devent-no/timergate_2/README.md

# timergate
PCB, 3D models, Firmware and software for timergates.
