devent-no/timergate_2/Software/timergate-ap/README.md

| Supported Targets | ESP32 | ESP32-C2 | ESP32-C3 | ESP32-C6 | ESP32-S2 | ESP32-S3 |
| --- | ----- | --- | --- | --- | --- | --- |

# Timergate Access Point

## Overview

### Build and Flash

After the webpage design work has been finished, you should compile them by running following commands:

```bash
cd path_to_this_example/front/web-demo
npm install
npm run build
```

After a while, you will see a `dist` directory which contains all the website files (e.g. html, js, css, images).

Run `idf.py -p PORT flash monitor` to build and flash the project..

(To exit the serial monitor, type ``Ctrl-]``.)

See the [Getting Started Guide](https://docs.espressif.com/projects/esp-idf/en/latest/get-started/index.html) for full steps to configure and use ESP-IDF to build projects.

### Extra steps to do for deploying website by semihost

We need to run the latest version of OpenOCD which should support semihost feature when we test this deploy mode:

```bash
openocd-esp32/bin/openocd -s openocd-esp32/share/openocd/scripts -f board/esp32-wrover-kit-3.3v.cfg
```

## Example Output

### Render webpage in browser

In your browser, enter the URL where the website located (e.g. `http://timergate.local`). You can also enter the IP address that ESP32 obtained if your operating system currently don't have support for mDNS service.

Besides that, this example also enables the NetBIOS feature with the domain name `timergate`. If your OS supports NetBIOS and has enabled it (e.g. Windows has native support for NetBIOS), then the URL `http://timergate` should also work.
