devent-no/timergate_2/Software/timergate-gui/README.md

# timergate-gui

This is a Vue 3 app with the Timergate gui.
This needs to be built before being packaged and added to the timergate AP. 

## Project Setup

```sh
npm install
```

### Compile and Hot-Reload for Development

```sh
npm run dev
```

### Compile and Minify for Production

```sh
npm run build
```

### Lint with [ESLint](https://eslint.org/)

```sh
npm run lint
```
