devent-no/timergate_2/PCB/IR-sensor-A2/Notes.txt

Notes Devent IR-sensor A1 -> A2
===============================

- Add DC block on receiver to remove sunlight. 
- Remove
