devent-no/timergate_2/BoM/BoM.pdf

# BoM Devent IR-sensor

Vare | Antall | Pris | Pris totalt | MPN | Supplier | Inventar | Behov | Innkjøp | Pris innkjøp
Aluramme | 2 | $37.14 | $74.28 | EN AW-6060 T66 40X40X4MM U-PRO | Elfa | 1 | 6 | 5 | $185.70
PCB RX/TX | 1 | $5.56 | $5.56 | | JLCPCB | 5 | 4 | 0 | $0.00
PCBA RX/TX | 1 | $18.44 | $18.44 | | JLCPCB | 5 | 4 | 0 | $0.00
PCB sensor | 7 | $1.30 | $9.10 | | JLCPCB | 10 | 28 | 18 | $23.40
PCBA sensor | 7 | $7.70 | $53.90 | | JLCPCB | 10 | 28 | 18 | $138.60
Ledninger for sensor | 7 | $2.85 | $19.95 | A08SUR08SUR32W305A | Digi-key | 4 | 28 | 24 | $68.40
Ladekrets | 1 | $7.48 | $7.48 | 18W Two-way 18650 | Banggood | 3 | 4 | 1 | $7.48
Batteri | 1 | $5.59 | $5.59 | USE-18650-2200PCB | Digi-key | 2 | 4 | 2 | $11.18
Antenne | 1 | $7.58 | $7.58 | ANT-24G-S21-P5FL | Digi-key | 2 | 4 | 2 | $15.16
Acryl-cover | 2 | 5 | $10.00 | 2 mm akryl | Bitmart | 0 | 4 | 4 | $20.00
USB-C-kontakt | 1 | 10.85 | $10.85 | USB C Type Connector | Aliexpress | 3 | 4 | 1 | $10.85
USB-C-ledning | 1 | 4.06 | $4.06 | CA-USB-AM-CM-3FT | Digi-key | 0 | 4 | 4 | $16.24
Refleks | 1 | 3.29 | $3.29 | 0.125-5-3431 | Digi-key | 4 | 0 | 0 | $0.00
Sum | | | $222.73 | | | | | | $497.01

3D-printede deler

Sensorskjerm | 7
Lokk | 1
Bunn | 1
Holder for lader | 1
