devent-no/timergate_2/BoM/BoM.ods

Vare | Antall | Pris | Pris totalt | MPN | Supplier | Inventar | Behov | Innkjøp | Pris innkjøp | OK | Link | Link2
Aluramme | 2 | $37.14 | $74.28 | EN AW-6060 T66 40X40X4MM U-PRO | Elfa | 4 | 8 | 4 | $148.56 | OK
PCB RX/TX | 1 | $5.56 | $5.56 |  | JLCPCB | 5 | 4 | 0 | $0.00 | OK
PCBA RX/TX | 1 | $18.44 | $18.44 |  | JLCPCB | 5 | 4 | 0 | $0.00 | OK
PCB sensor | 7 | $1.30 | $9.10 |  | JLCPCB | 10 | 28 | 18 | $23.40
PCBA sensor | 7 | $7.70 | $53.90 |  | JLCPCB | 10 | 28 | 18 | $138.60
IR-mottager | 7 | $0.56 | $3.92 | 1540051EC3590 | Digi-key | 10 | 28 | 18 | $10.08 | OK
IR-sender | 7 | $1.50 | $10.50 | VSLY5940 | Digi-key | 10 | 28 | 18 | $27.00 | OK
Ledninger for sensor | 7 | $2.85 | $19.95 | A08SUR08SUR32W305A | Digi-key | 4 | 28 | 24 | $68.40 | OK
Ladekrets | 1 | $7.48 | $7.48 | 18W Two-way 18650 | Banggood/pfdeal | 3 | 4 | 1 | $7.48 | OK | https://www.pfdeal.com/products/18w-two-way-18650-battery-fast-charge-shield-board-for-lipo-battery | https://www.banggood.com/18W-Two-way-18650-Battery-Fast-Charge-Shield-Board-for-Lipo-Battery-p-1931453.html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
Batteri | 1 | $5.59 | $5.59 | USE-18650-2200PCB | Kjell.com | 2 | 4 | 2 | $11.18 |  | https://www.kjell.com/no/produkter/kontor/batterier/litiumbatterier/kjell-company-18650-li-ion-batteri-36-v-2600-mah-4-pk.-p32072
Antenne | 1 | $7.58 | $7.58 | ANT-24G-S21-P5FL | Digi-key | 4 | 4 | 0 | $0.00 | OK
Acryl-cover | 2 | 5 | $10.00 | 2 mm akryl | Bitmart | 0 | 4 | 4 | $20.00
Acryplate bunn | 2 |  |  | 4 mm acryl | Bitmart | 0 | 8 | 8
USB-C-kontakt | 1 | 10.85 | $10.85 | USB C Type Connector | Aliexpress | 4 | 4 | 0 | $0.00 | OK | https://www.aliexpress.com/item/1005002215361710.html
USB-C-ledning | 1 | 4.06 | $4.06 | CA-USB-AM-CM-3FT | Digi-key | 0 | 4 | 4 | $16.24 | OK
Refleks | 1 | 3.29 | $3.29 | 0.125-5-3431 | Digi-key | 4 | 0 | 0 | $0.00 | OK
M3 inserts-sensor | 34 | 0.11928 | $4.06 | M30X226C | Digi-key | 0
M3 inserts reflektor | 20 | 0.11928 | $2.39 | M30X226C | Digi-key | 0
M3x8 senkehode | 16
Sum |  |  | $237.15 |  |  |  |  |  | $470.94
3D-printede deler
Sensorskjerm | 7
Lokk | 1
Bunn | 1
Holder for lader | 1
Lokk-reflektor | 1
Bunn reflektor | 1
