devent-no/timergate_2/Models/Alu-Pole.FCStd

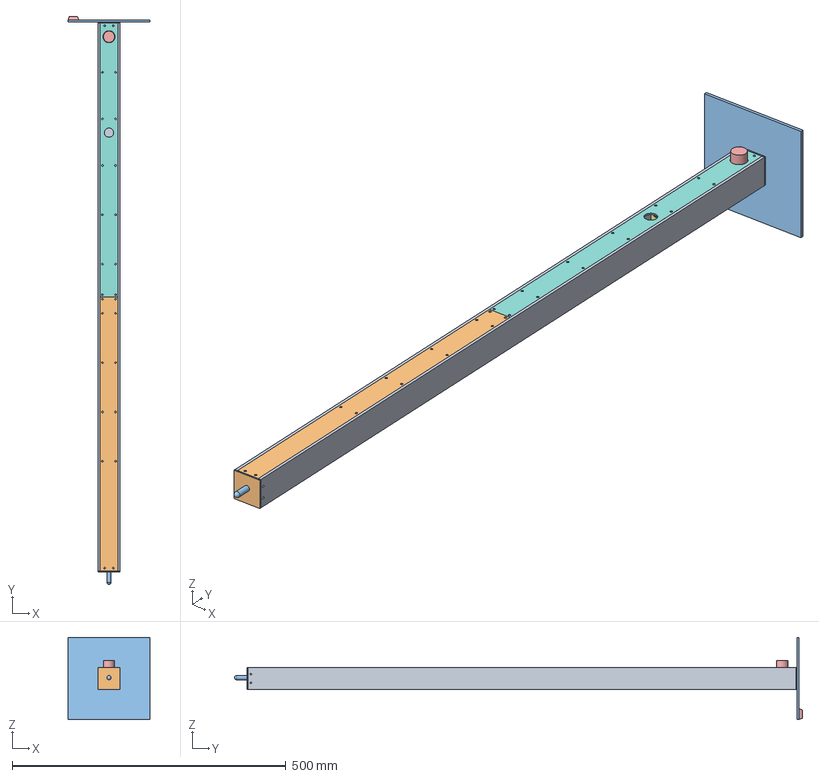
[picture p1: CAD file, 2025-02-21]
Models/Alu-Pole.FCStd
150.0 x 1037.0 x 150.0 mm
Aluminium-Profile
ABS-Top
Antenna
Charger
USB-C
ABS-Bottom
Charger-holder-2
Acrylic-front-bottom
Charger-holder-003
Acrylic-front-top
Acrylic-base
ABS-Joint
Rubber-Feet
Spacer
Old-Charger-holder
R_0402_1005Metric016
C_0402_1005Metric010
LED_D5.0mm
C_0402_1005Metric012
R_0402_1005Metric018
R_0402_1005Metric020
SOIC_14_39x87mm_P127mm
SOT-23-3
SOT_23
R_0402_1005Metric022
R_0402_1005Metric024
C_0402_1005Metric014
R_0402_1005Metric026
R_0402_1005Metric028
SOT_024
C_0402_1005Metric016
R_0402_1005Metric030
LED_D5.0mm002
R_0402_1005Metric032
R_0402_1005Metric034
R_0402_1005Metric036
PinSocket_2x10_P127mm_Horizontal001
C_0402_1005Metric018
R_0402_1005Metric038
PinHeader_2x10_P127mm_Horizontal
C_0402_1005Metric020
C_0402_1005Metric022
R_0402_1005Metric040
C_0402_1005Metric024
C_0402_1005Metric026
C_0402_1005Metric028
C_0402_1005Metric030
R_0402_1005Metric042
R_0402_1005Metric044
C_0402_1005Metric032
C_0402_1005Metric034
C_0402_1005Metric036
C_0402_1005Metric038
R_0402_1005Metric046
C_0402_1005Metric040
C_0402_1005Metric042
SOT_23_5
C_0402_1005Metric044
IR-sensor_PCB
USB-plug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
