devent-no/timergate_2/PCB/IR-sensor-A2/IR-sensor-A2.step

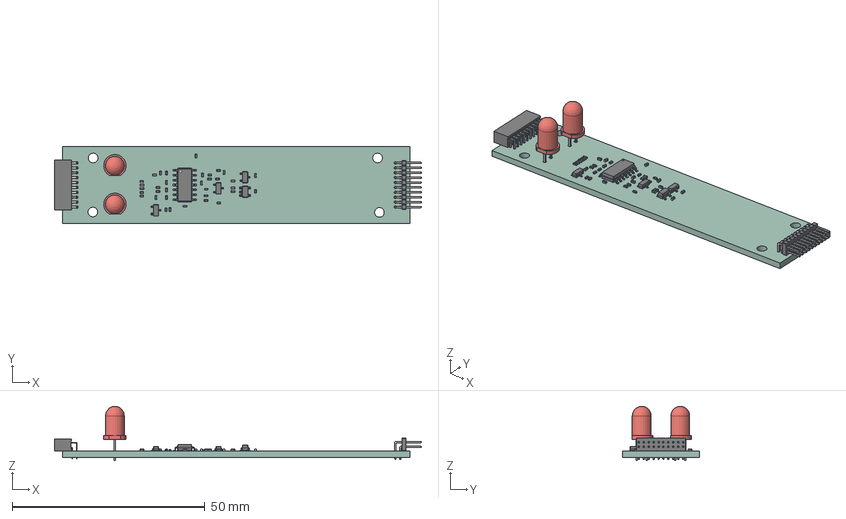
[picture p2: CAD file, 2025-01-06]
PCB/IR-sensor-A2/IR-sensor-A2.step
95.1 x 20.0 x 14.1 mm
R_0402_1005Metric x 16
C_0402_1005Metric x 18
LED_D5.0mm x 2
SOIC_14_39x87mm_P127mm
SOT-23-3
SOT_23 x 2
PinSocket_2x10_P127mm_Horizontal
PinHeader_2x10_P127mm_Horizontal
SOT_23_5
IR-sensor_PCB
