devent-no/timergate_2/PCB/Receiver-A0/Receiver.step

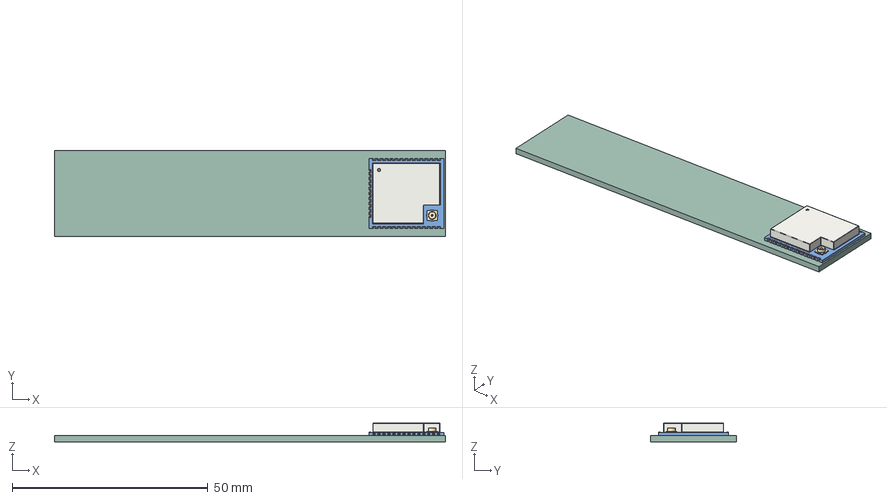
[picture p3: CAD file, 2024-08-15]
PCB/Receiver-A0/Receiver.step
100.0 x 22.0 x 4.85 mm
Receiver PCB
