devent-no/timergate_2/PCB/Receiver-A2/Receiver-A2.step

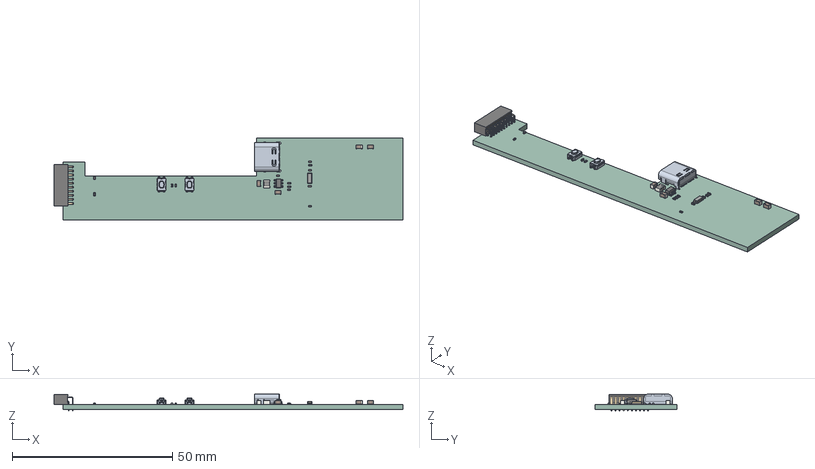
[picture p4: CAD file, 2025-01-06]
PCB/Receiver-A2/Receiver-A2.step
108.9 x 25.5 x 5.20 mm
C_0402_1005Metric x 5
C_0805_2012Metric x 4
L_1008_2520Metric
R_0402_1005Metric x 8
SOT_23_6
PinSocket_2x10_P127mm_Horizontal
Crystal_SMD_3215-2Pin_3.2x1.5mm
Receiver_PCB
