devent-no/timergate_2/Models/Alu-Calibration.FCStd

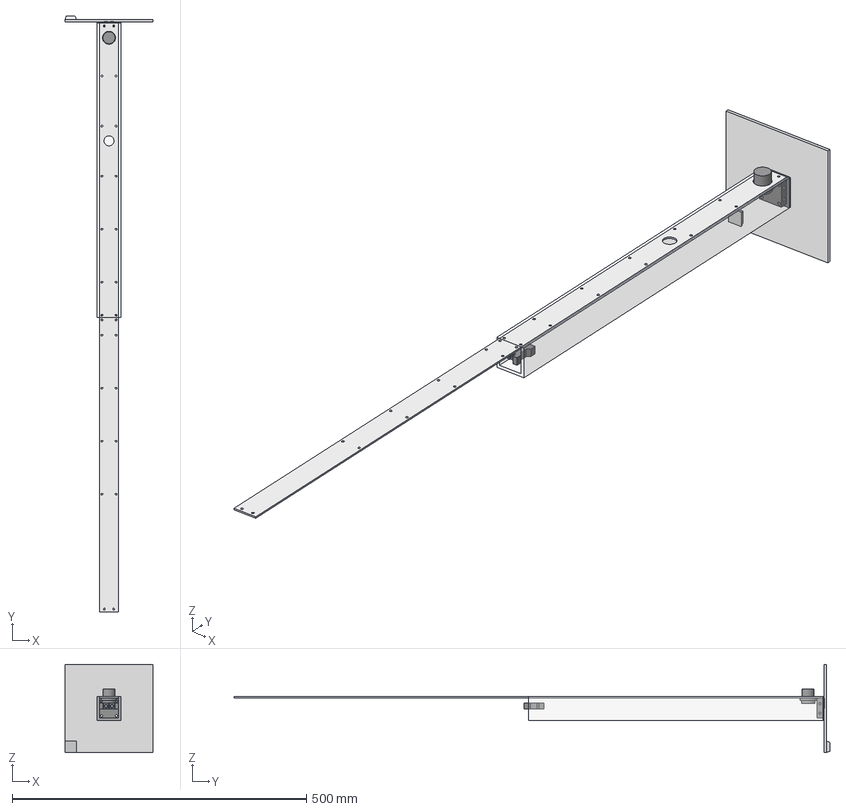
[picture p5: CAD file, 2025-01-06]
Models/Alu-Calibration.FCStd
150.0 x 1012.0 x 150.0 mm
Aluminium-Profile
USB-C
ABS-Bottom
Acrylic-front-bottom
Acrylic-front-top
Acrylic-base
Rubber-Feet
Sensor-holder-sun-3
