devent-no/timergate_2/PCB/IR-sensor-A2/IR-sensor.step

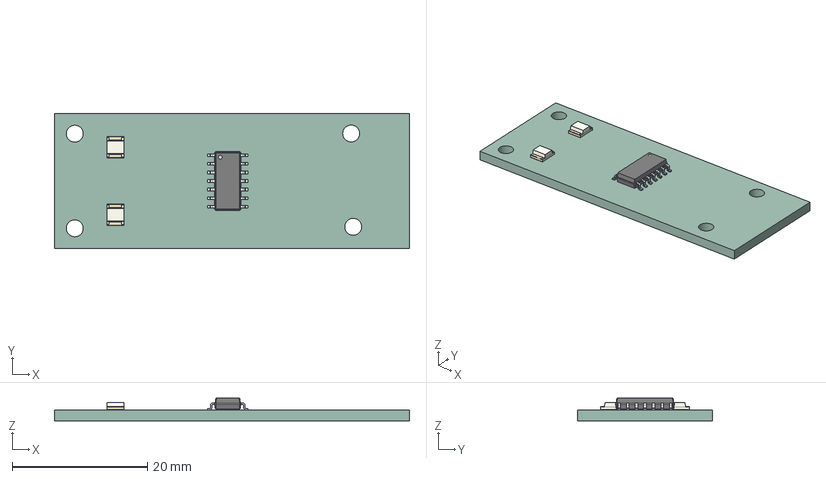
[picture p6: CAD file, 2024-08-15]
PCB/IR-sensor-A2/IR-sensor.step
52.5 x 20.0 x 3.40 mm
IR-sensor PCB
