devent-no/timergate_2/Models/Alu-Reflector.FCStd

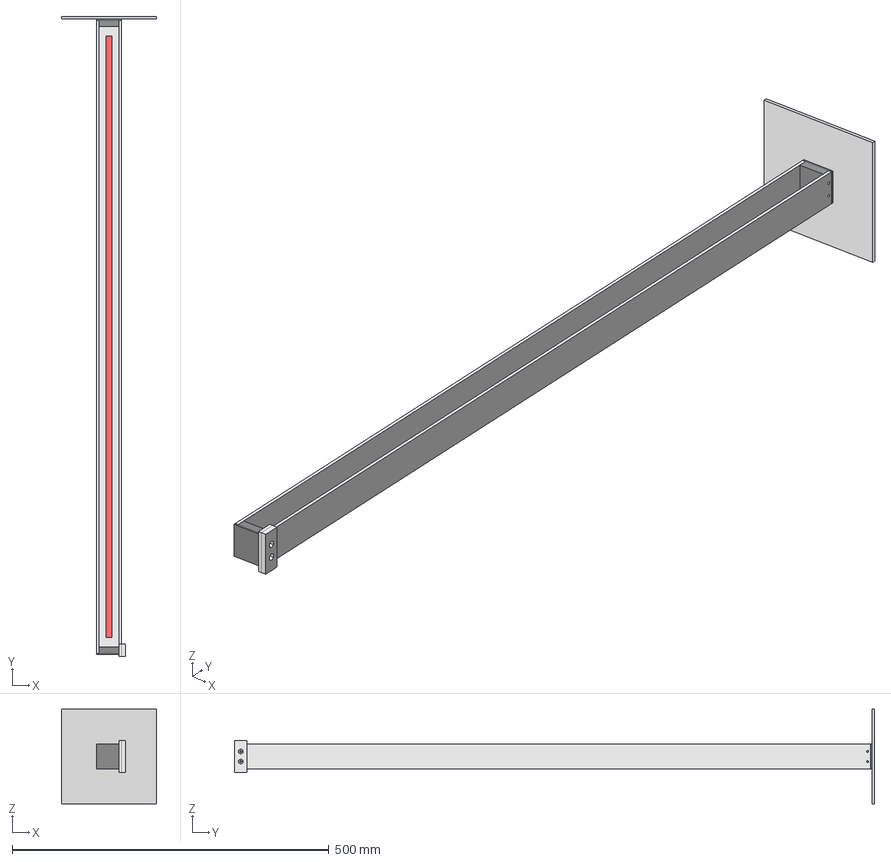
[picture p7: CAD file, 2024-08-20]
Models/Alu-Reflector.FCStd
150.0 x 1011.0 x 150.0 mm
Aluminium
Bottom
Top
Acrylic-bottom
Reflective-tape
Mal
