devent-no/timergate_2/Models/Alu-Base.FCStd

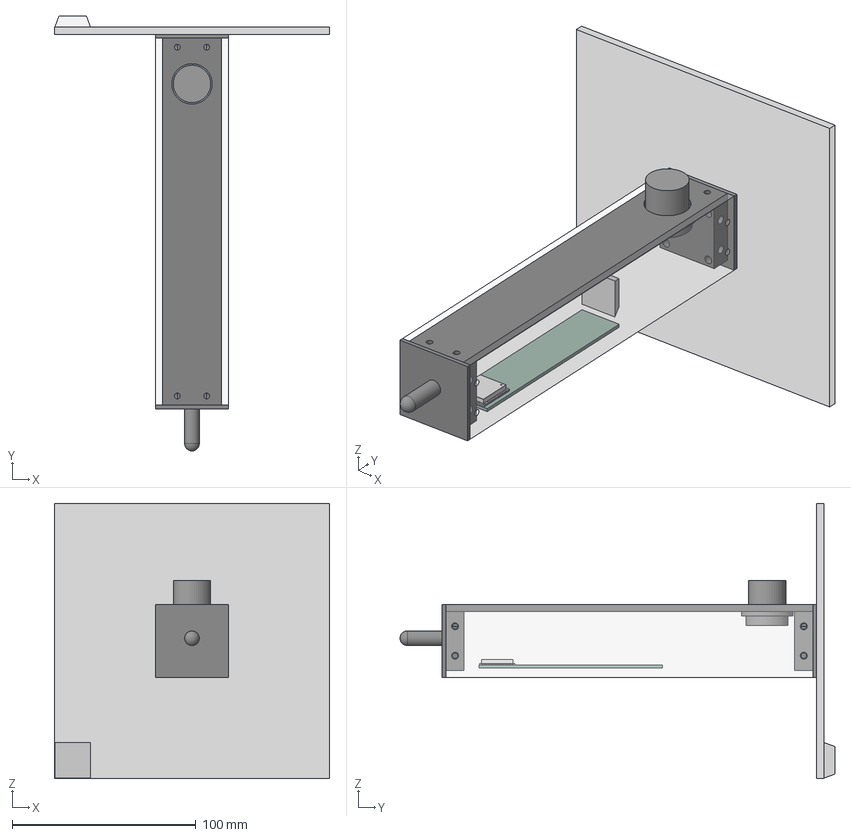
[picture p8: CAD file, 2024-08-15]
Models/Alu-Base.FCStd
150.0 x 237.0 x 150.0 mm
Aluminium
Receiver PCB
Top
Antenna
USB-C
Bottom
Acrylic-front
Acrylic-base
Feet
