devent-no/timergate_2/PCB/IR-sensor-A2/IR-sensor.kicad_pcb

## KiCad design PCB/IR-sensor-A2/IR-sensor.kicad_pcb (2025-02-20)

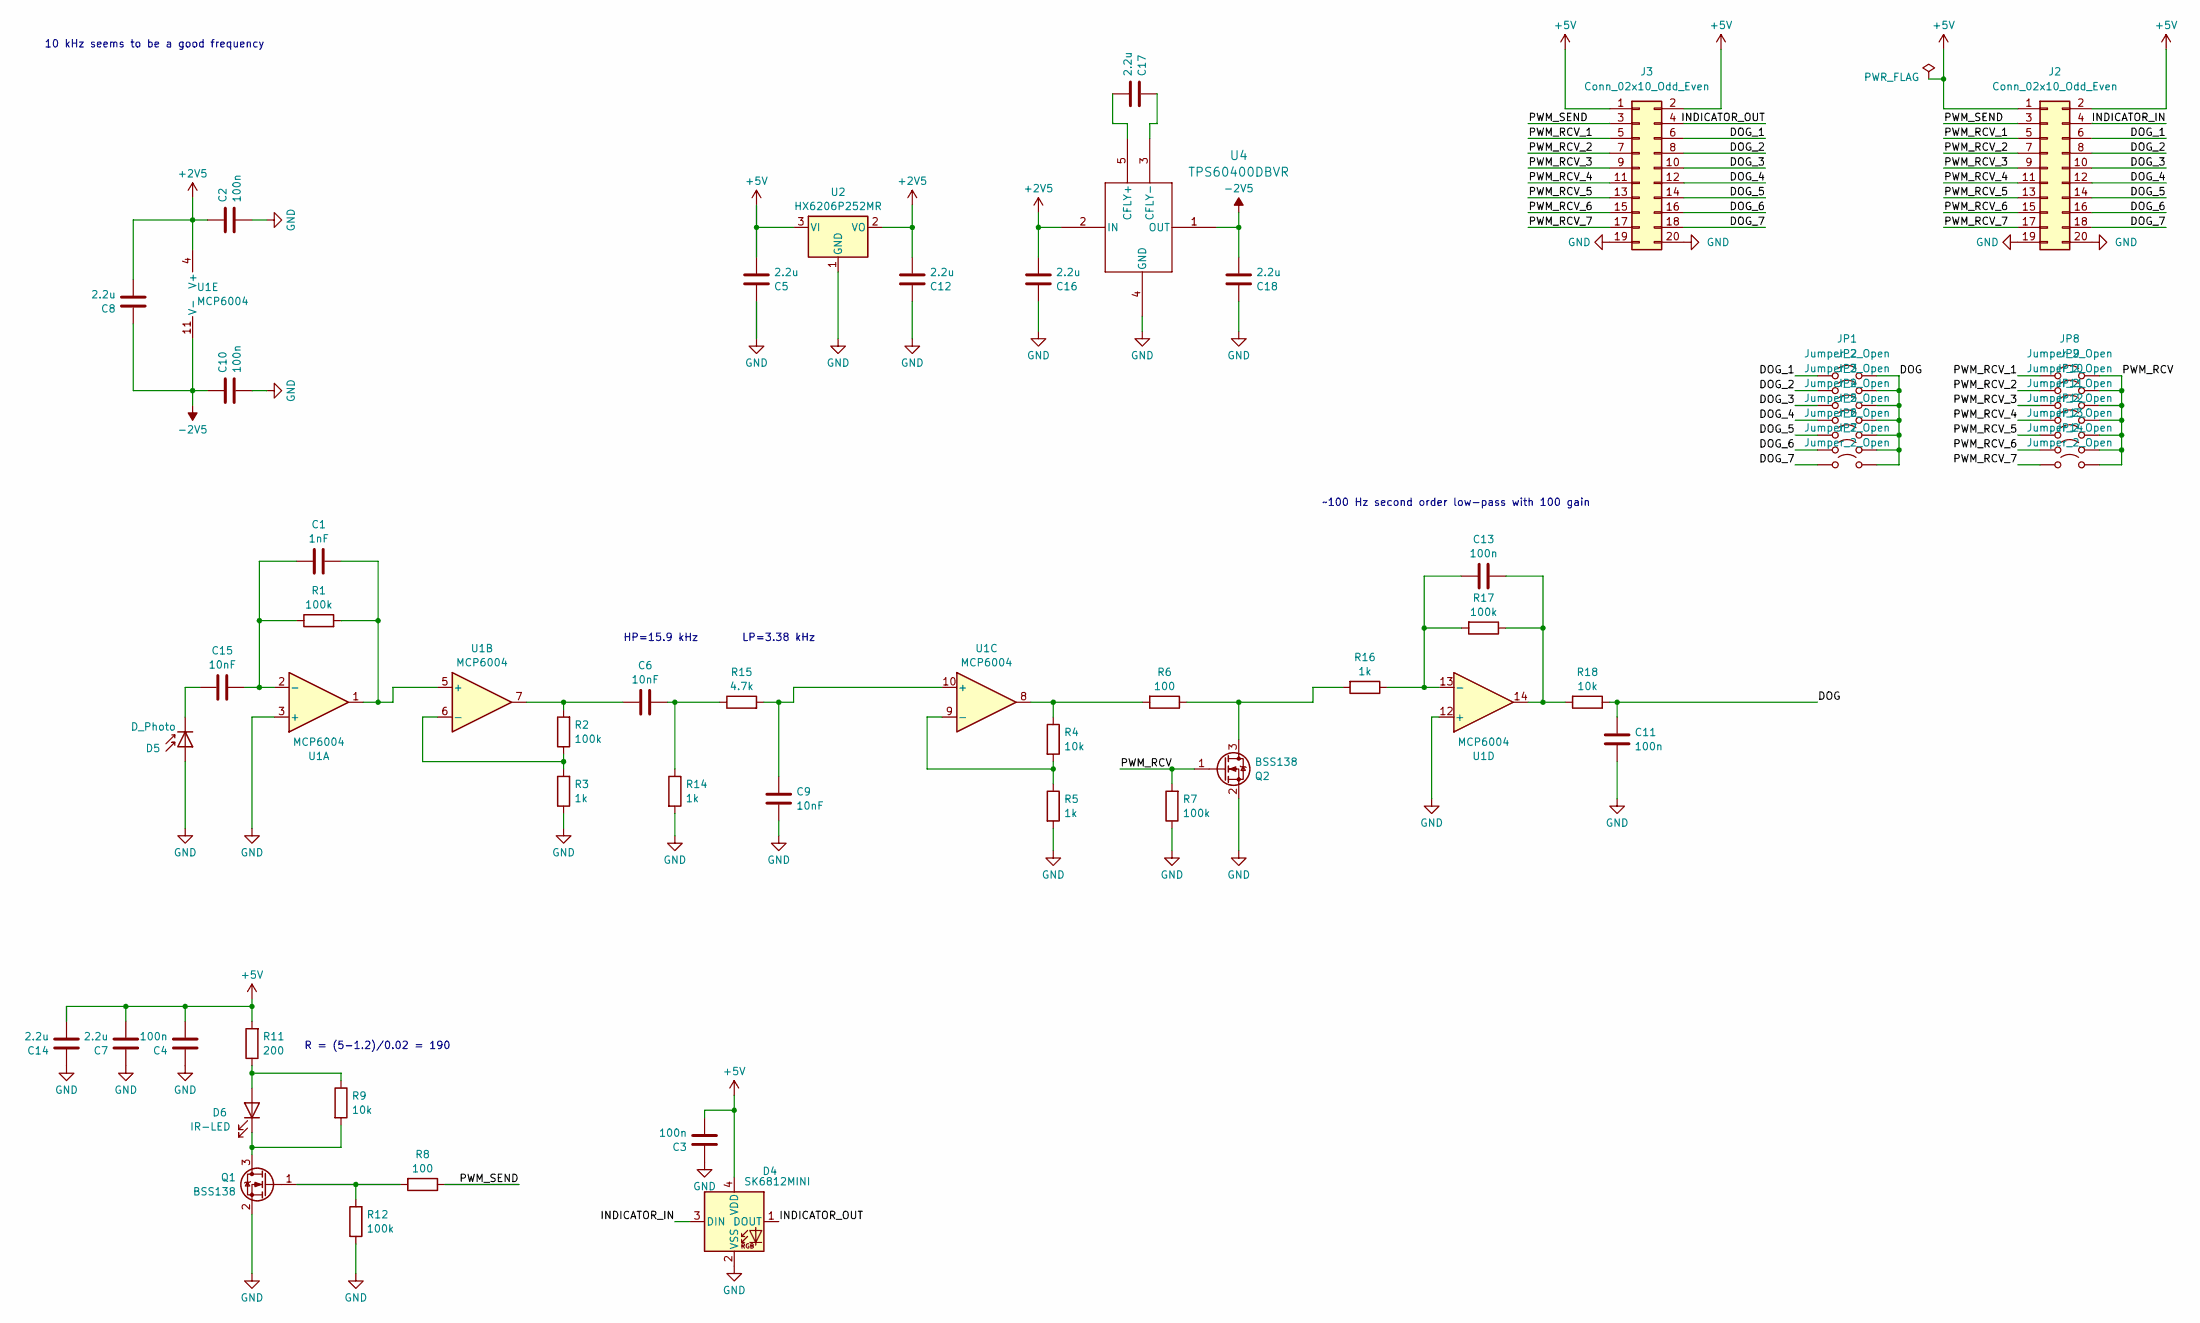
[picture p9: schematic IR-sensor.kicad_sch]

Parts:
C1: 1nF; C_0402_1005Metric; MPN CC0402KRX7R9BB102
C2, C3, C4, C10, C11, C13: 100n; C_0402_1005Metric; MPN CC0402KRX5R9BB104
C5, C7, C8, C12, C14, C16, C17, C18: 2.2u; C_0402_1005Metric; MPN CL05A225MQ5NSNC
C6, C9, C15: 10nF; C_0402_1005Metric; MPN CC0402KRX7R7BB103
D4: SK6812MINI; LED_SK6812MINI_PLCC4_3.5x3.5mm_P1.75mm; MPN SK6812mini
D5: D_Photo; LED_D5.0mm; MPN 1540051EC3590
D6: IR-LED; LED_D5.0mm; MPN VSLY5940
J2: Conn_02x10_Odd_Even; PinHeader_2x10_P1.27mm_Horizontal; MPN IPCP127M20PB28R
J3: Conn_02x10_Odd_Even; PinSocket_2x10_P1.27mm_Horizontal; MPN IPCP127F20PB28R
JP1, JP2, JP3, JP4, JP5, JP6, JP7, JP8, JP9, JP10, JP11, JP12, JP13, JP14: Jumper_2_Open; SolderJumper-2_P1.3mm_Open_Pad1.0x1.5mm
Q1, Q2: BSS138; SOT-23; MPN 4530-BSS138CT-ND
R1, R2, R7, R12, R17: 100k; R_0402_1005Metric; MPN RC0402FR-07100KL
R3, R5, R14, R16: 1k; R_0402_1005Metric; MPN 0402WGF1001TCE
R4, R9, R18: 10k; R_0402_1005Metric; MPN RC0402FR-0710KL
R6, R8: 100; R_0402_1005Metric; MPN RC0402FR-07100RL
R11: 200; R_0402_1005Metric; MPN 0402WGF2000TCE
R15: 4.7k; R_0402_1005Metric; MPN RC0402FR-074K7L
U1: MCP6004; SOIC-14_3.9x8.7mm_P1.27mm; MPN MCP6004T-I/SL
U2: HX6206P252MR; SOT-23-3; MPN HX6206P252MR
U4: TPS60400DBVR; SOT-23-5; MPN TPS60400DBVR

Connections:
+2V5: C2.2, C8.1, C12.2, C16.2, U1.4 (V+), U2.2 (VO), U4.2 (IN)
+5V: C3.1, C4.1, C5.2, C7.1, C14.1, D4.4 (VDD), J2.1, J2.2, J3.1, J3.2, R11.2, U2.3 (VI)
-2V5: C8.2, C10.2, C18.2, U1.11 (V-), U4.1 (OUT)
/DOG: C11.1, JP1.2 (B), JP2.2 (B), JP3.2 (B), JP4.2 (B), JP5.2 (B), JP6.2 (B), JP7.2 (B), R18.1
/DOG_1: J2.6, J3.6, JP1.1 (A)
/DOG_2: J2.8, J3.8, JP2.1 (A)
/DOG_3: J2.10, J3.10, JP3.1 (A)
/DOG_4: J2.12, J3.12, JP4.1 (A)
/DOG_5: J2.14, J3.14, JP5.1 (A)
/DOG_6: J2.16, J3.16, JP6.1 (A)
/DOG_7: J2.18, J3.18, JP7.1 (A)
/INDICATOR_IN: D4.3 (DIN), J2.4
/INDICATOR_OUT: D4.1 (DOUT), J3.4
/PWM_RCV: JP8.2 (B), JP9.2 (B), JP10.2 (B), JP11.2 (B), JP12.2 (B), JP13.2 (B), JP14.2 (B), Q2.1 (G), R7.2
/PWM_RCV_1: J2.5, J3.5, JP8.1 (A)
/PWM_RCV_2: J2.7, J3.7, JP9.1 (A)
/PWM_RCV_3: J2.9, J3.9, JP10.1 (A)
/PWM_RCV_4: J2.11, J3.11, JP11.1 (A)
/PWM_RCV_5: J2.13, J3.13, JP12.1 (A)
/PWM_RCV_6: J2.15, J3.15, JP13.1 (A)
/PWM_RCV_7: J2.17, J3.17, JP14.1 (A)
/PWM_SEND: J2.3, J3.3, R8.1
GND: C2.1, C3.2, C4.2, C5.1, C7.2, C9.2, C10.1, C11.2, C12.1, C14.2, C16.1, C18.1, D4.2 (VSS), D5.2 (A), J2.19, J2.20, J3.19, J3.20, Q1.2 (S), Q2.2 (S), R3.1, R5.2, R7.1, R12.1, R14.2, U1.3 (+), U1.12 (+), U2.1 (GND), U4.4 (GND)
unnamed: C6.1, R14.1, R15.1
unnamed: C6.2, R2.2, U1.7
unnamed: C13.1, R17.1, R18.2, U1.14
unnamed: C15.2, D5.1 (K)
unnamed: D6.2 (A), R9.1, R11.1
unnamed: D6.1 (K), Q1.3 (D), R9.2
unnamed: Q1.1 (G), R8.2, R12.2
unnamed: Q2.3 (D), R6.1, R16.2
unnamed: R4.1, R6.2, U1.8
unnamed: C1.1, C15.1, R1.1, U1.2 (-)
unnamed: C1.2, R1.2, U1.1, U1.5 (+)
unnamed: R2.1, R3.2, U1.6 (-)
unnamed: C9.1, R15.2, U1.10 (+)
unnamed: R4.2, R5.1, U1.9 (-)
unnamed: C13.2, R16.1, R17.2, U1.13 (-)
unnamed: C17.2, U4.5 (CFLY+)
unnamed: C17.1, U4.3 (CFLY-)

Notes on the sheet:
R = (5-1.2)/0.02 = 190
LP=3.38 kHz
10 kHz seems to be a good frequency
HP=15.9 kHz
~100 Hz second order low-pass with 100 gain

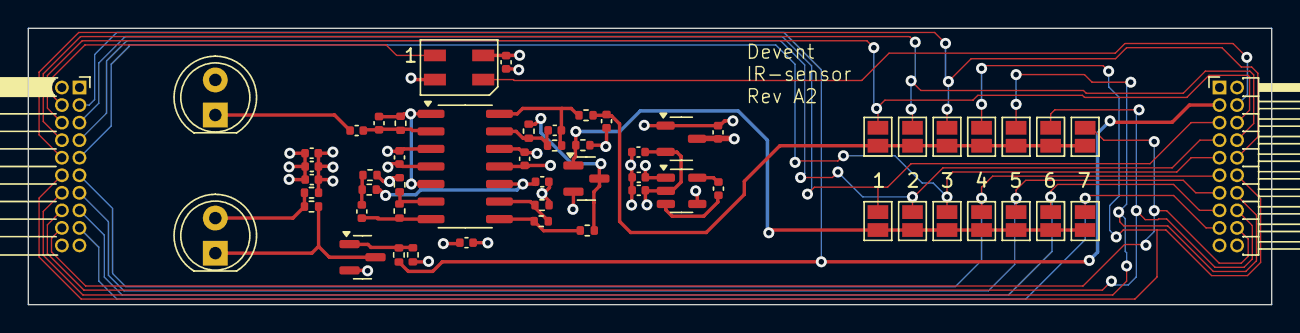
[picture p10: board PCB/IR-sensor-A2/IR-sensor.kicad_pcb from above]

Board: 4 copper layers, 90.0 x 20.0 mm, 58 parts (0 on the bottom side), 40 nets.
