devent-no/timergate_2/PCB/Receiver-A2/Receiver.kicad_pcb

## KiCad design PCB/Receiver-A2/Receiver.kicad_pcb (2025-02-20)

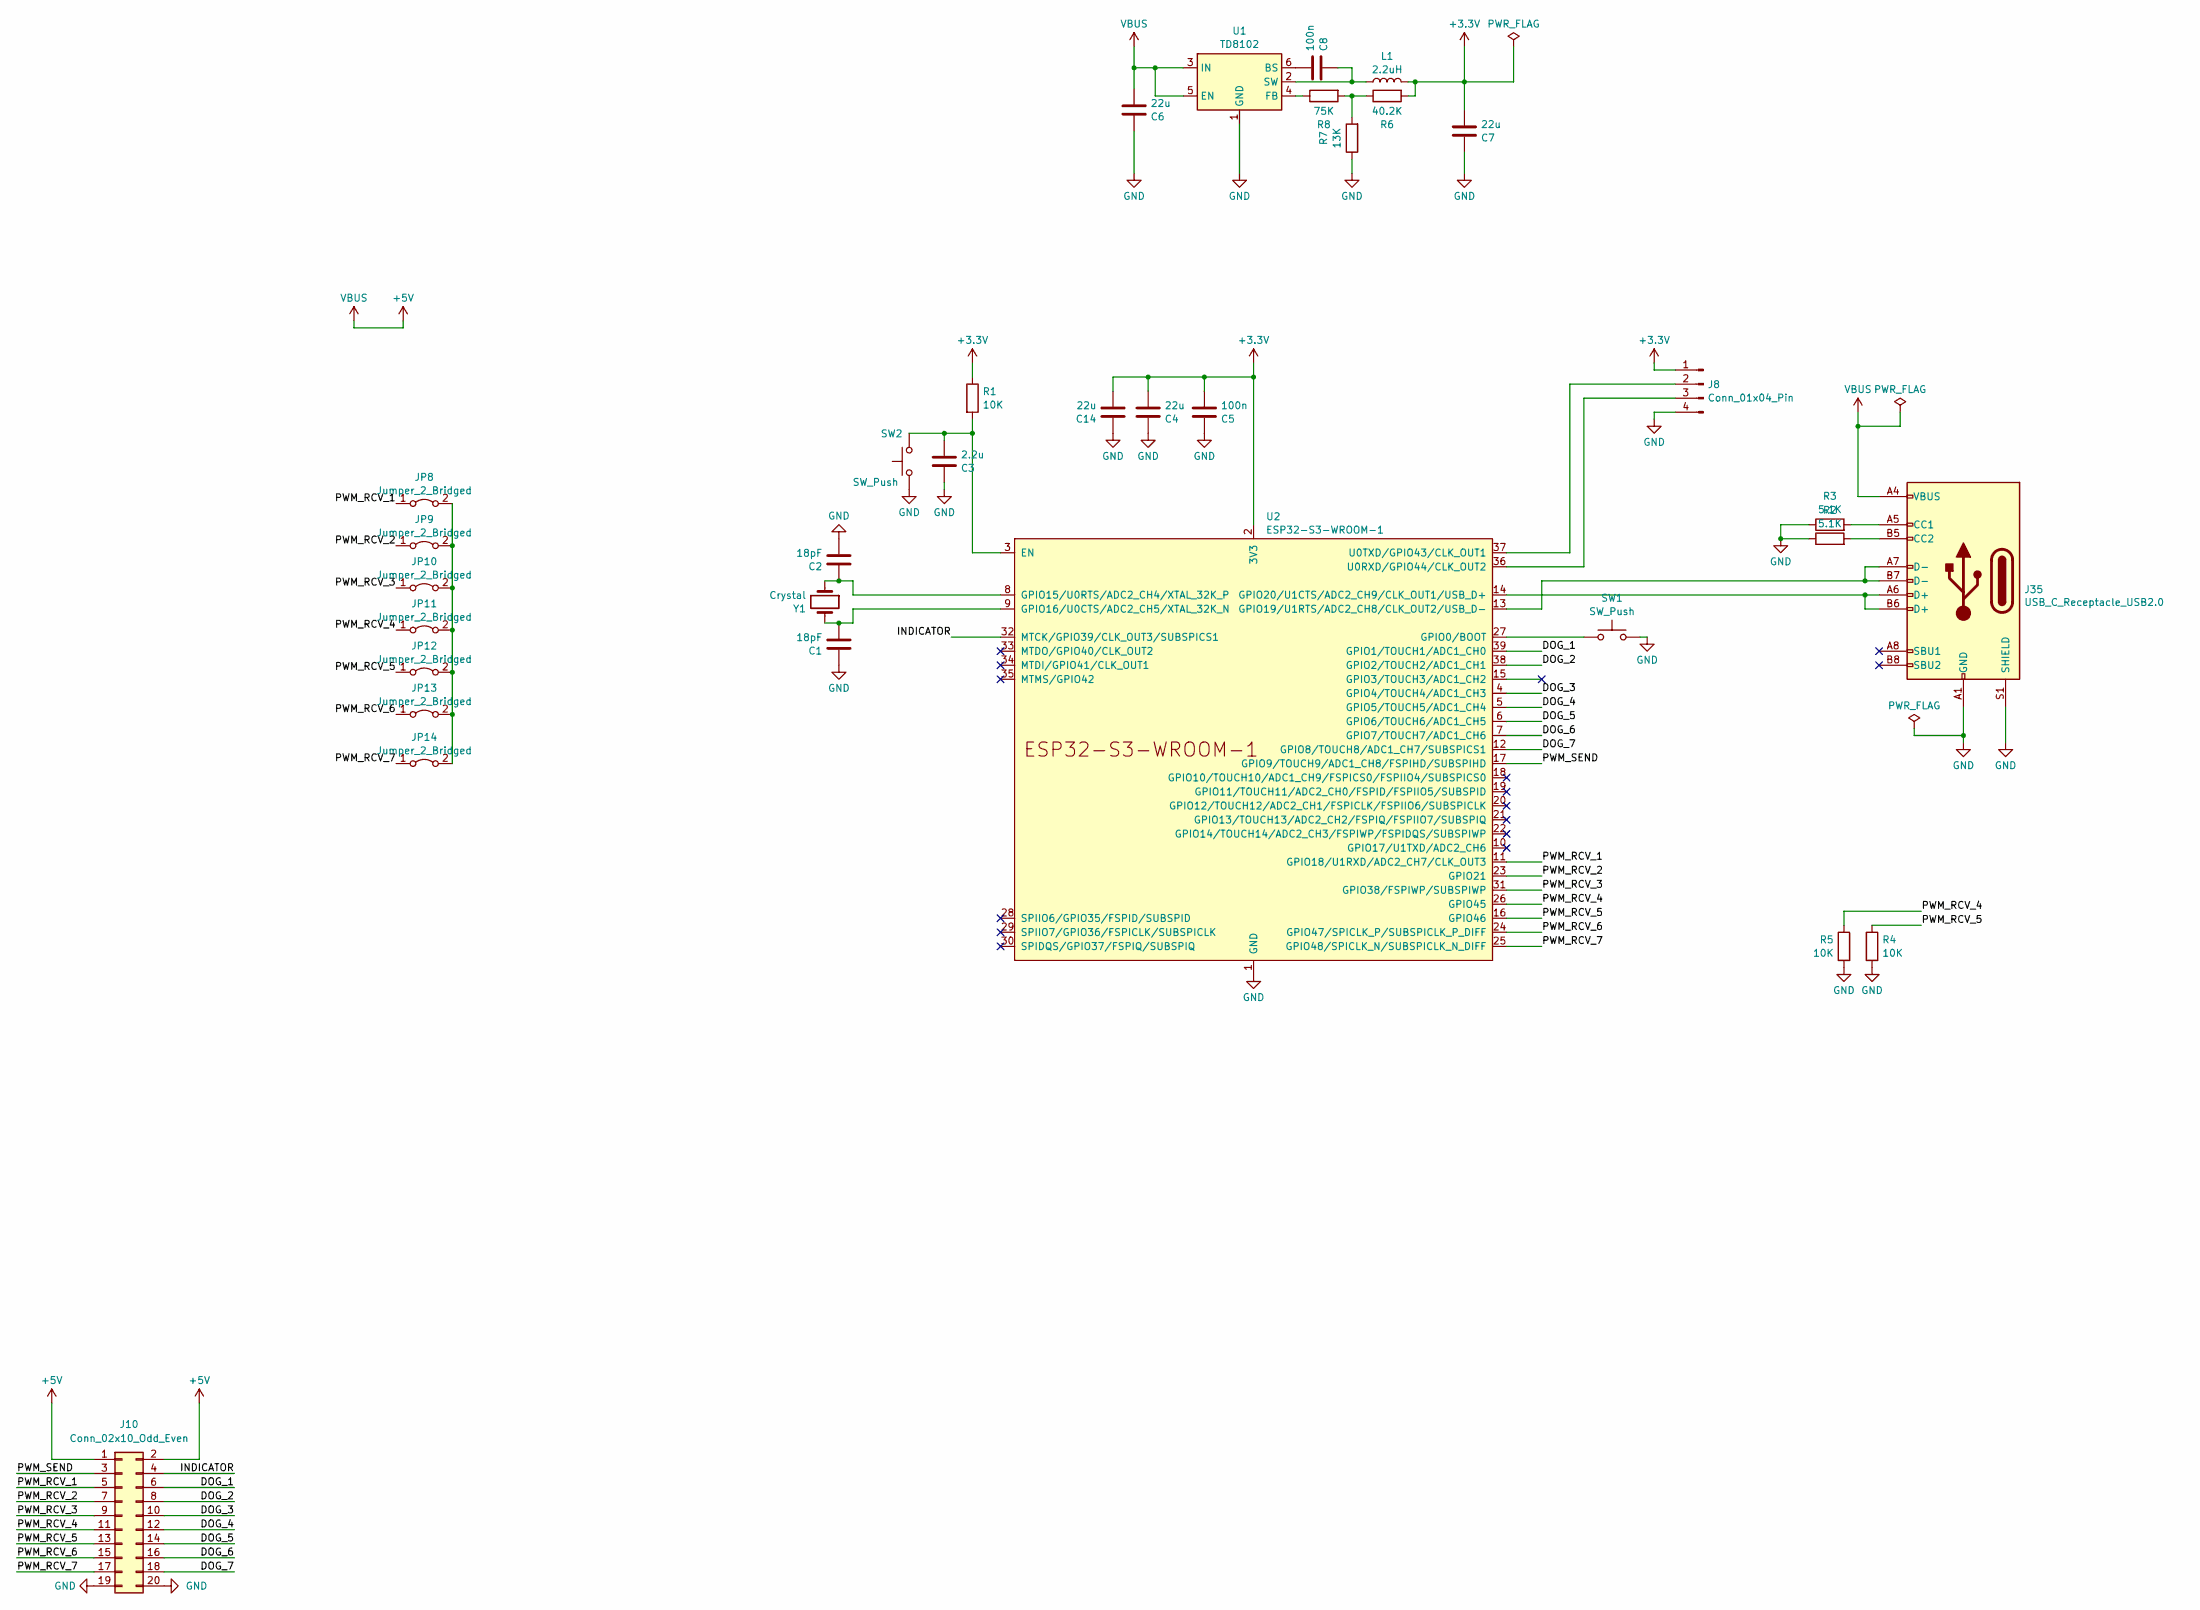
[picture p11: schematic Receiver.kicad_sch, Timergate-Receiver]

Parts:
C1, C2: 18pF; C_0402_1005Metric; MPN CC0402JRNPO9BN180
C3: 2.2u; C_0402_1005Metric; MPN CL05A225MQ5NSNC
C4, C6, C7, C14: 22u; C_0805_2012Metric; MPN CL21A226MPQNNNG
C5, C8: 100n; C_0402_1005Metric; MPN CC0402KRX5R9BB104
J8: Conn_01x04_Pin; PinHeader_1x04_P2.54mm_Vertical_SMD_Pin1Left
J10: Conn_02x10_Odd_Even; PinSocket_2x10_P1.27mm_Horizontal; MPN IPCP127F20PB28R
J35: USB_C_Receptacle_USB2.0; USB-C; MPN U262-161N-4BVC11
JP8, JP9, JP10, JP11, JP12, JP13, JP14: Jumper_2_Bridged; SolderJumper-2_P1.3mm_Bridged_Pad1.0x1.5mm
L1: 2.2uH; L_1008_2520Metric; MPN SLO252010T4R7MTT
R1, R4, R5: 10K; R_0402_1005Metric; MPN RC0402FR-0710KL
R2, R3: 5.1K; R_0402_1005Metric; MPN RC0402JR-075K1L
R6: 40.2K; R_0402_1005Metric; MPN RC0402FR-0739K2L
R7: 13K; R_0402_1005Metric; MPN RC0402JR-0713KL
R8: 75K; R_0402_1005Metric; MPN RC0402FR-0775KL
SW1, SW2: SW_Push; TSA343G0; MPN TSA343G00-250DZY
U1: TD8102; SOT-23-6; MPN TD8102
U2: ESP32-S3-WROOM-1; MPN ESP32-S3-WROOM-1U-N4R2
Y1: Crystal; Crystal_SMD_3215-2Pin_3.2x1.5mm; MPN Q13FC1350000400

Connections:
+3.3V: C4.2, C5.2, C7.2, C14.2, J8.1, L1.2, R1.1, R6.2, U2.2 (3V3)
+5V: C6.2, J10.1, J10.2, U1.3 (IN), U1.5 (EN); also elsewhere on the board
/DOG_1: J10.6, U2.39 (GPIO1/TOUCH1/ADC1_CH0)
/DOG_2: J10.8, U2.38 (GPIO2/TOUCH2/ADC1_CH1)
/DOG_3: J10.10, U2.4 (GPIO4/TOUCH4/ADC1_CH3)
/DOG_4: J10.12, U2.5 (GPIO5/TOUCH5/ADC1_CH4)
/DOG_5: J10.14, U2.6 (GPIO6/TOUCH6/ADC1_CH5)
/DOG_6: J10.16, U2.7 (GPIO7/TOUCH7/ADC1_CH6)
/DOG_7: J10.18, U2.12 (GPIO8/TOUCH8/ADC1_CH7/SUBSPICS1)
/INDICATOR: J10.4, U2.32 (MTCK/GPIO39/CLK_OUT3/SUBSPICS1)
/PWM_RCV_1: J10.5, JP8.1 (A), U2.11 (GPIO18/U1RXD/ADC2_CH7/CLK_OUT3)
/PWM_RCV_2: J10.7, JP9.1 (A), U2.23 (GPIO21)
/PWM_RCV_3: J10.9, JP10.1 (A), U2.31 (GPIO38/FSPIWP/SUBSPIWP)
/PWM_RCV_4: J10.11, JP11.1 (A), R5.1, U2.26 (GPIO45)
/PWM_RCV_5: J10.13, JP12.1 (A), R4.1, U2.16 (GPIO46)
/PWM_RCV_6: J10.15, JP13.1 (A), U2.24 (GPIO47/SPICLK_P/SUBSPICLK_P_DIFF)
/PWM_RCV_7: J10.17, JP14.1 (A), U2.25 (GPIO48/SPICLK_N/SUBSPICLK_N_DIFF)
/PWM_SEND: J10.3, U2.17 (GPIO9/TOUCH9/ADC1_CH8/FSPIHD/SUBSPIHD)
GND: C1.1, C2.2, C3.1, C4.1, C5.1, C6.1, C7.1, C14.1, J8.4, J10.19, J10.20, R2.1, R3.1, R4.2, R5.2, R7.1, SW1.2, SW2.1, U1.1 (GND), U2.1 (GND), U2.40 (GND), U2.41 (GND); also elsewhere on the board
unnamed 19: R3.2; also elsewhere on the board
unnamed 20: R2.2; also elsewhere on the board
unnamed: J8.2, U2.37 (U0TXD/GPIO43/CLK_OUT1)
unnamed: J8.3, U2.36 (U0RXD/GPIO44/CLK_OUT2)
unnamed: JP8.2 (B), JP9.2 (B), JP10.2 (B), JP11.2 (B), JP12.2 (B), JP13.2 (B), JP14.2 (B)
unnamed: R6.1, R7.2, R8.2
unnamed: C8.2, U1.6 (BS)
unnamed: R8.1, U1.4 (FB)
unnamed: C8.1, L1.1, U1.2 (SW)
unnamed: C3.2, R1.2, SW2.2, U2.3 (EN)
unnamed: SW1.1, U2.27 (GPIO0/BOOT)
unnamed: C2.1, U2.8 (GPIO15/U0RTS/ADC2_CH4/XTAL_32K_P), Y1.1
unnamed: C1.2, U2.9 (GPIO16/U0CTS/ADC2_CH5/XTAL_32K_N), Y1.2
unnamed 32: U2.13 (GPIO19/U1RTS/ADC2_CH8/CLK_OUT2/USB_D-); also elsewhere on the board
unnamed 33: U2.14 (GPIO20/U1CTS/ADC2_CH9/CLK_OUT1/USB_D+); also elsewhere on the board

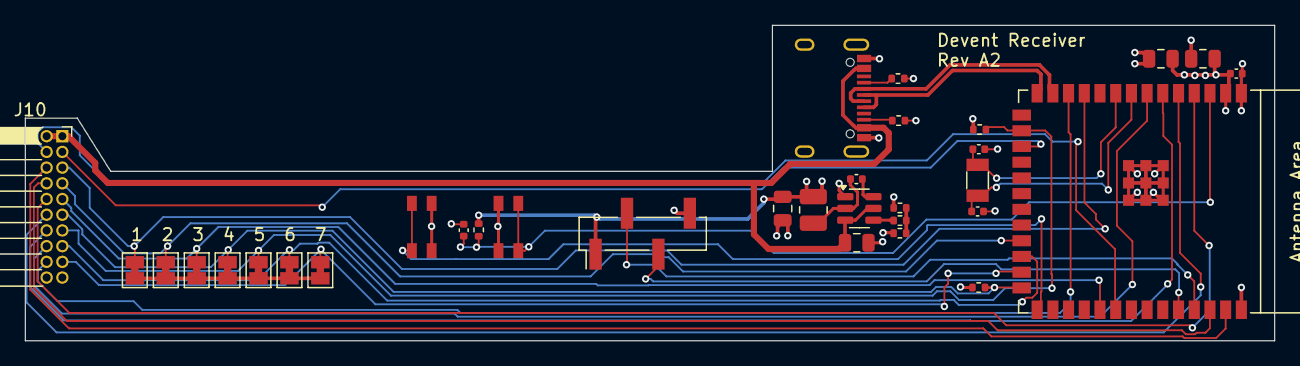
[picture p12: board Receiver.kicad_pcb from above]

Board: 4 copper layers, 101.0 x 25.5 mm, 33 parts (0 on the bottom side), 34 nets.

Other parts of the board:
J6: USB_C_Receptacle_USB2.0; USB-C

Their connections:
+5V: J6.A4 (VBUS), J6.A9 (VBUS); also elsewhere on the board
GND: J6.A1 (GND), J6.A12 (GND), J6.S1 (SHIELD); also elsewhere on the board
unnamed 19: J6.A5 (CC1); also elsewhere on the board
unnamed 20: J6.B5 (CC2); also elsewhere on the board
unnamed 32: J6.A7 (D-), J6.B7 (D-); also elsewhere on the board
unnamed 33: J6.A6 (D+), J6.B6 (D+); also elsewhere on the board
