devent-no/timergate_2/PCB/IR-sensor-A0/IR-sensor.kicad_pcb

## KiCad design PCB/IR-sensor-A0/IR-sensor.kicad_pcb (2024-08-15, an earlier design)

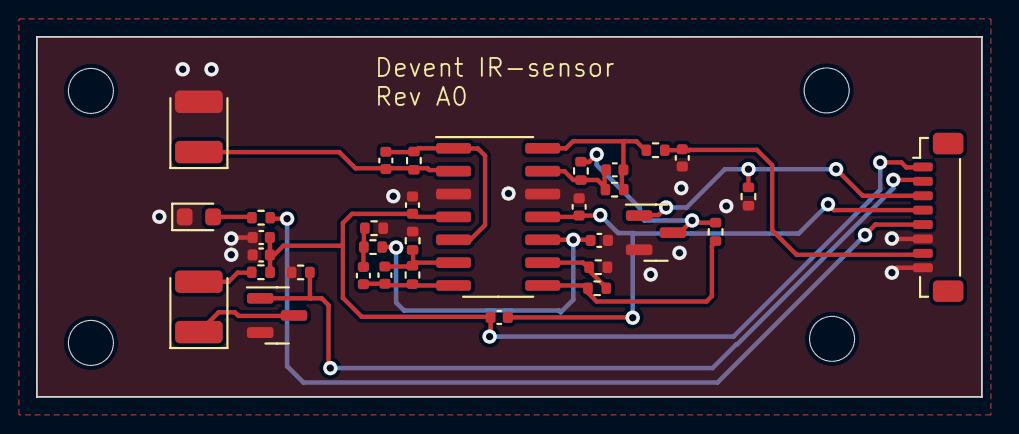
[picture p13: board PCB/IR-sensor-A0/IR-sensor.kicad_pcb from above]

Board: 2 copper layers, 52.5 x 20.0 mm, 37 parts (0 on the bottom side), 21 nets.

Parts:
C1, C5: 10n; C_0402_1005Metric
C2, C3, C4, C6, C9, C10, C11, C13: 100n; C_0402_1005Metric
C7: 2.2u; C_0402_1005Metric
D1: IR-LED; LED_1210_3225Metric
D2: D_Photo; LED_1210_3225Metric
D3: LED; LED_0603_1608Metric
H1, H2, H3, H4: MountingHole; MountingHole_2.5mm
J1: Conn_01x06_Pin; JST_SUR_BM08B-SURS-TF_1x08-1MP_P0.80mm_Vertical
Q1, Q2: BSS138; SOT-23
R1, R2, R7, R12, R17: 100k; R_0402_1005Metric
R3, R5, R13, R14, R16: 1k; R_0402_1005Metric
R4, R18: 10k; R_0402_1005Metric
R6: 100; R_0402_1005Metric
R11: 27; R_0402_1005Metric
R15: 4.7k; R_0402_1005Metric
U1: MCP6004; SOIC-14_3.9x8.7mm_P1.27mm

Connections:
+2V5: C2.2, C3.1, C4.1, C7.1, J1.1, R11.2, U1.4 (V+)
-2V5: C3.2, C10.2, J1.4, U1.11 (V-)
/DOG: C11.1, J1.7, R18.1
/INDICATOR: J1.5, R13.2
/PWM_RCV: J1.3, Q2.1 (G), R7.2
/PWM_SEND: J1.2, Q1.1 (G), R12.2
GND: C2.1, C4.2, C7.2, C9.2, C10.1, C11.2, D2.2 (A), D3.1 (K), J1.6, J1.8, Q1.2 (S), Q2.2 (S), R3.1, R5.2, R7.1, R12.1, R14.2, U1.3 (+), U1.12 (+)
unnamed: C5.2, C6.2, R2.2, U1.7
unnamed: C6.1, R14.1, R15.1
unnamed: C13.1, R17.1, R18.2, U1.14
unnamed: D1.2 (A), R11.1
unnamed: D1.1 (K), Q1.3 (D)
unnamed: C1.1, D2.1 (K), R1.1, U1.2 (-)
unnamed: D3.2 (A), R13.1
unnamed: Q2.3 (D), R6.1, R16.2
unnamed: R4.1, R6.2, U1.8
unnamed: C1.2, R1.2, U1.1, U1.5 (+)
unnamed: C5.1, R2.1, R3.2, U1.6 (-)
unnamed: C9.1, R15.2, U1.10 (+)
unnamed: R4.2, R5.1, U1.9 (-)
unnamed: C13.2, R16.1, R17.2, U1.13 (-)
