devent-no/timergate_2/Software/timergate-ap/main/timergate_server.c

//Sjekk, er vi i rett fil? 3.8.25 09:45

//
//--------------- Del 1: Inkluderinger, definisjoner og strukturer ----------------
//


#include <stdio.h>
#include <string.h>
#include <stdlib.h>
#include <dirent.h>
#include <errno.h>
#include <inttypes.h>
#include "freertos/FreeRTOS.h"
#include "freertos/task.h"
#include "esp_log.h"
#include "esp_system.h"
#include "nvs_flash.h"
#include "esp_netif.h"
#include "esp_event.h"
#include "esp_wifi.h"
#include "esp_http_server.h"
#include "cJSON.h"
#include "lwip/sockets.h"
#include "esp_spiffs.h"
#include "lwip/sockets.h"
#include "esp_netif_net_stack.h"

#include "mdns.h"
#include "esp_timer.h"

#include "esp_timer.h"
#include "esp_now.h"
#include "esp_mac.h"


// Definer MIN-makroen
#ifndef MIN
#define MIN(a, b) (((a) < (b)) ? (a) : (b))
#endif

#define MAX_WS_CLIENTS 5
#define FILE_PATH_MAX 512
#define SPIFFS_READ_SIZE 512

// TCP server definisjoner
#define PORT 3333
#define KEEPALIVE_IDLE 1
#define KEEPALIVE_INTERVAL 1
#define KEEPALIVE_COUNT 3

// Legg til disse nye definisjonene
#define MAX_POLES 5
#define MAX_TCP_POLES 2

// Struktur for å lagre informasjon om tilkoblede målestolper via TCP
typedef struct {
    int sock;
    bool connected;
    char mac[18];            // MAC-adresse format: "xx:xx:xx:xx:xx:xx"
    char nominal_mac[18];    // "Nominell" MAC-adresse som brukes i GUI
} tcp_pole_t;



// Struktur for å lagre siste brudd for debouncing
typedef struct {
    uint8_t mac[ESP_NOW_ETH_ALEN];  // MAC-adresse til målestolpen
    int32_t sensor_id;              // Sensor-ID (0-6)
    uint32_t last_break_time;       // Tidspunkt for siste brudd (sekunder)
    uint32_t last_break_micros;     // Mikrosekunder del
} last_break_record_t;

// Array for å holde siste brudd per sensor/målestolpe
#define MAX_SENSORS_PER_POLE 7
static last_break_record_t last_breaks[MAX_POLES * MAX_SENSORS_PER_POLE];
static int last_break_count = 0;

// Konfigurerbar debounce-tid i millisekunder
static int break_debounce_ms = 1000; // Standard: 1 sekund





// Datastruktur for å lagre informasjon fra målestolpene
typedef struct {
    uint8_t mac[ESP_NOW_ETH_ALEN];  // MAC-adresse til målestolpen
    uint8_t k;                      // Type melding (0=ADC verdier, 1=Sensor breaks, 2=Settings)
    uint32_t t;                     // Timestamp (sekunder)
    uint32_t u;                     // Mikrosekunder
    int32_t v[7];                   // ADC verdier
    int32_t b[7];                   // Broken status
    int32_t o[7];                   // Offsets
    int32_t e[7];                   // Enabled status
} pole_data_t;



// Struktur for å spore passeringsdeteksjon
typedef struct {
    uint8_t mac[ESP_NOW_ETH_ALEN];       // MAC-adresse til målestolpen
    bool sensor_triggered[MAX_SENSORS_PER_POLE]; // Status for hver sensor
    int unique_sensors_count;            // Antall unike sensorer utløst i sekvensen
    uint32_t first_break_time;           // Tidspunkt for første brudd i sekvensen (sekunder)
    uint32_t first_break_micros;         // Mikrosekunder del av tidspunkt for første brudd
    uint32_t sequence_start_time;        // Starttidspunkt for gjeldende sekvens
    uint32_t last_passage_time;          // Tidspunkt for siste passering (for debouncing)
    uint32_t last_passage_micros;        // Mikrosekunder del av tidspunkt for siste passering
    // Legg til disse nye variablene:
    bool use_sensor_time_scale;          // Sant hvis vi bruker sensor-tid for denne sekvensen
    uint32_t last_sensor_time;           // Siste tidspunkt fra sensoren
    uint32_t last_sensor_micros;         // Mikrosekunder del    
    int first_sensor_id_candidate;
    bool passage_sent_this_sequence;  // NY: Flag for om K4 er sendt
} passage_detection_t;


// Nye strukturer for discovery og pairing
typedef struct {
    uint32_t system_id;      // 0x00000000 = søker system
    uint8_t msg_type;        // MSG_POLE_ANNOUNCE
    uint8_t mac[6];          // Målestolpens MAC
    char device_name[16];    // "TimerGate Pole"
    uint8_t firmware_ver[3]; // [1, 2, 3]
    int8_t rssi_estimate;    // For avstandsestimering
} __attribute__((packed)) pole_announce_t;

typedef struct {
    uint32_t system_id;      // AP's System ID
    uint8_t msg_type;        // MSG_SYSTEM_ASSIGN
    uint8_t target_mac[6];   // Målestolpens MAC
    char system_name[32];    // "Timergate Nord"
} __attribute__((packed)) system_assign_t;



typedef struct {
    uint32_t system_id;      // 0x00000000 for broadcast eller current_system_id
    uint8_t msg_type;        // MSG_IDENTIFY_REQUEST
    uint8_t target_mac[6];   // Spesifikk målestolpe
    uint8_t duration_sec;    // Hvor lenge den skal blinke (5-30 sekunder)
} __attribute__((packed)) identify_request_t;


// Kommando-protokoll for ESP-NOW
typedef struct {
    uint32_t system_id;      // System ID for isolasjon
    uint8_t msg_type;        // MSG_COMMAND
    uint8_t target_mac[6];   // Spesifikk målestolpe eller broadcast
    uint8_t command_type;    // TIME_SYNC, RESTART, HSEARCH, etc.
    uint8_t data[];          // Kommando-spesifikk data
} __attribute__((packed)) command_msg_t;


typedef struct {
    uint8_t mac[6];
    char device_name[16];
    time_t first_seen;
    time_t last_seen;
    int8_t rssi;
    bool identifying;        // Om den blinker nå
    uint8_t firmware_ver[3];
} discovered_pole_t;


// Struktur for tilknyttede (paired) målestolper
typedef struct {
    uint8_t mac[6];
    char name[32];           // "Start Gate", "Finish Gate"
    bool enabled;
    time_t paired_time;      // Når den ble tilknyttet
    time_t last_seen;        // Siste aktivitet
    uint32_t firmware_version;
    char user_notes[64];     // "Nordre målestolpe"
} paired_pole_t;

#define MAX_PAIRED_POLES 10



// Struktur for å spore kommunikasjonskvalitet per målestolpe
typedef struct {
    uint8_t mac[ESP_NOW_ETH_ALEN];
    int8_t last_rssi;                // Siste RSSI-verdi
    int8_t avg_rssi;                 // Gjennomsnittlig RSSI (siste 10 målinger)
    uint32_t packets_received;       // Totalt mottatte pakker
    uint32_t last_packet_time;       // Tidspunkt for siste pakke
    int8_t rssi_history[10];         // RSSI-historikk for gjennomsnitt
    int rssi_history_index;          // Index i RSSI-historikk
    time_t last_update;              // Siste oppdatering
} signal_quality_t;

// Array for å holde signalkvalitet per målestolpe
#define MAX_SIGNAL_TRACKING 10
static signal_quality_t signal_tracking[MAX_SIGNAL_TRACKING];
static int signal_tracking_count = 0;
static SemaphoreHandle_t signal_mutex;




// Discovery protokoll konstanter
#define MSG_SENSOR_DATA        0x01
#define MSG_PASSAGE_DETECTED   0x02
#define MSG_POLE_ANNOUNCE      0x10
#define MSG_SYSTEM_ASSIGN      0x11
#define MSG_IDENTIFY_REQUEST   0x20
#define MSG_COMMAND            0x30


#define MAX_DISCOVERED_POLES   10




// Array for å holde passeringsdeteksjonsstatus per målestolpe
#define MAX_PASSAGE_DETECTORS MAX_POLES
static passage_detection_t passage_detectors[MAX_PASSAGE_DETECTORS];
//static uint32_t passage_counter = 0; // Teller for unike passeringer, er vist ikke i bruk lenger...
static int passage_detector_count = 0;
static SemaphoreHandle_t passage_mutex;



// Ny struktur for stoppeklokke-passeringer med dual timing
typedef struct {
    uint8_t mac[ESP_NOW_ETH_ALEN];     // MAC-adresse til målestolpen
    uint32_t server_time_sec;          // Server-tid for stoppeklokke-beregninger
    uint32_t server_time_usec;         // Server-mikrosekunder
    uint32_t pole_time_sec;            // Målestolpe-tid for logging/debugging
    uint32_t pole_time_usec;           // Målestolpe-mikrosekunder
    int sensor_count;                  // Antall sensorer som utløste
    uint32_t passage_id;               // Unik ID for denne passeringen
} stopwatch_passage_t;

#define MAX_STOPWATCH_PASSAGES 10      // Maks antall stoppeklokke-passeringer
static stopwatch_passage_t stopwatch_passages[MAX_STOPWATCH_PASSAGES];
static int stopwatch_passage_count = 0;
static uint32_t next_passage_id = 1;   // Teller for unike passage-ID-er
static SemaphoreHandle_t stopwatch_mutex;

// Strukt for å holde styr på sendte passeringer (duplikatdeteksjon)
typedef struct {
    uint8_t mac[ESP_NOW_ETH_ALEN];     // MAC-adresse til målestolpen
    uint32_t timestamp_sec;            // Tidspunkt for passeringen (sekunder)
    uint32_t timestamp_micros;         // Mikrosekunder del
    int sensors_count;                 // Antall sensorer som utløste
    time_t send_time;                  // Når passeringen ble sendt (for cleanup)
} sent_passage_t;

#define MAX_SENT_PASSAGES 20           // Hvor mange tidligere passeringer vi holder styr på
static sent_passage_t sent_passages[MAX_SENT_PASSAGES];
static int sent_passage_count = 0;
static SemaphoreHandle_t sent_passages_mutex;

// Discovery og pairing variabler
static discovered_pole_t discovered_poles[MAX_DISCOVERED_POLES];
static int discovered_pole_count = 0;
static bool discovery_active = true;  // Standard på for å oppdage nye målestolper
static SemaphoreHandle_t discovery_mutex;

// Paired poles variabler
static paired_pole_t paired_poles[MAX_PAIRED_POLES];
static int32_t paired_pole_count = 0;
static SemaphoreHandle_t paired_poles_mutex;

//static uint32_t current_system_id = 0;  // Vil bli satt ved oppstart



// Konfigurasjon for passeringsdeteksjon
static int passage_debounce_ms = 1000;   // Standard debounce-tid: 1 sekund
static int min_sensors_for_passage = 2;  // Standard minimum antall sensorer
static int sequence_timeout_ms = 500;   // Timeout for sekvens: 5 sekunder



// Datastruktur for passeringshistorikk
typedef struct {
    uint8_t mac[ESP_NOW_ETH_ALEN];
    uint32_t timestamp_sec;
    uint32_t timestamp_usec;
    int sensors_count;
    int sensor_ids[MAX_SENSORS_PER_POLE];  // Hvilke sensorer som utløste
    uint32_t time_since_previous_ms;       // Tid siden forrige i millisekunder
} passage_history_t;

#define MAX_PASSAGE_HISTORY 20
static passage_history_t passage_history[MAX_PASSAGE_HISTORY];
static int passage_history_count = 0;
static uint32_t total_passages = 0;
static SemaphoreHandle_t passage_history_mutex;



// Globale variabler for å lagre data fra målestolpene
static pole_data_t pole_data[MAX_POLES];
static int pole_count = 0;
static SemaphoreHandle_t pole_data_mutex;

static tcp_pole_t tcp_poles[MAX_TCP_POLES];
static SemaphoreHandle_t tcp_poles_mutex;

static const char *TAG = "timergate-ap";


// System ID for isolasjon mellom Timergate-systemer
static uint32_t current_system_id = 0;
static SemaphoreHandle_t system_id_mutex;

// Meldingstyper for ESP-NOW kommunikasjon
#define MSG_SENSOR_DATA        0x01
#define MSG_PASSAGE_DETECTED   0x02
#define MSG_POLE_ANNOUNCE      0x10
#define MSG_SYSTEM_ASSIGN      0x11
#define MSG_IDENTIFY_REQUEST   0x20
#define MSG_COMMAND            0x30

// Kommandotyper
#define CMD_TIME_SYNC      0x01
#define CMD_RESTART        0x02
#define CMD_HSEARCH        0x03
#define CMD_SET_BREAK      0x04
#define CMD_SET_ENABLED    0x05
#define CMD_POWER_OFF      0x06

#define CMD_SET_BREAK      0x04
#define CMD_SET_ENABLED    0x05
#define CMD_POWER_OFF      0x06
#define CMD_POWER_ON       0x07
#define CMD_RESTART_SOFT   0x08
#define CMD_RESTART_HARD   0x09
#define CMD_RESTART_FACTORY 0x0A
#define CMD_UNPAIR         0x0B






// ESP-NOW meldingsformat med System ID
typedef struct {
    uint32_t system_id;      // Unikt per system
    uint8_t msg_type;        // SENSOR_DATA, COMMAND, ANNOUNCE, etc.
    uint8_t data[];          // Payload
} __attribute__((packed)) timergate_msg_t;




static void log_event_passering(const char *mac, int sensor_id, const char *status,
                                double timestamp, int count, int debounce_ms,
                                int sensors_used[], int sensor_count)
{
    if (strcmp(status, "PASSERING") == 0) {
        ESP_LOGI(TAG, "🎯 PASSERING: MAC=%s, sensor=%d, tid=%.3f, sensorer utløst=%d [",
                 mac, sensor_id, timestamp, sensor_count);
        for (int i = 0; i < sensor_count; i++) {
            printf("%d%s", sensors_used[i], (i < sensor_count - 1) ? "," : "");
        }
        printf("]\n");
    } else if (strcmp(status, "TIMEOUT") == 0) {
        ESP_LOGW(TAG, "⏱️ TIMEOUT: MAC=%s, sensor=%d, tid=%.3f, sensorer utløst=%d",
                 mac, sensor_id, timestamp, count);
    } else if (strcmp(status, "DEBOUNCE") == 0) {
        ESP_LOGI(TAG, "⛔ DEBOUNCE: MAC=%s, sensor=%d, %d ms etter forrige passering",
                 mac, sensor_id, debounce_ms);
    } else if (strcmp(status, "IGNORED") == 0) {
        ESP_LOGD(TAG, "ℹ️ Ignorert sensor-gjenoppretting: MAC=%s, sensor=%d", mac, sensor_id);
    } else {
        ESP_LOGI(TAG, "📍 EVENT: MAC=%s, sensor=%d, status=%s, tid=%.3f",
                 mac, sensor_id, status, timestamp);
    }
}



// Funksjonsdeklarasjoner
void init_esp_now(void);
void initialize_system_id(void);
uint32_t get_system_id(void);
bool is_message_for_us(const timergate_msg_t *msg);
esp_err_t send_esp_now_message(const uint8_t *dest_mac, uint8_t msg_type, const void *payload, size_t payload_len);
bool send_esp_now_command_to_pole(const uint8_t *mac, uint8_t cmd_type, const void *data, size_t data_len);
esp_err_t get_system_id_handler(httpd_req_t *req);

// Implementasjon av send_esp_now_command_to_pole
bool send_esp_now_command_to_pole(const uint8_t *mac, uint8_t cmd_type, const void *data, size_t data_len) {
    if (!mac) {
        ESP_LOGE(TAG, "Ugyldig MAC-adresse for ESP-NOW kommando");
        return false;
    }
    
    // Sjekk om peer eksisterer, og legg til hvis ikke
    if (!esp_now_is_peer_exist(mac)) {
        esp_now_peer_info_t peer_info = {0};
        memcpy(peer_info.peer_addr, mac, ESP_NOW_ETH_ALEN);
        peer_info.channel = 0;
        peer_info.ifidx = WIFI_IF_AP;
        peer_info.encrypt = false;
        
        esp_err_t peer_result = esp_now_add_peer(&peer_info);
        if (peer_result != ESP_OK) {
            ESP_LOGE(TAG, "❌ Kunne ikke legge til ESP-NOW peer: %s", esp_err_to_name(peer_result));
            return false;
        }
        ESP_LOGI(TAG, "✅ Lagt til ESP-NOW peer for kommando-sending");
    }
    
    // Beregn total størrelse for kommando-melding
    size_t total_size = sizeof(command_msg_t) + data_len;
    
    // Allokér buffer for kommando-melding
    uint8_t *msg_buffer = malloc(total_size);
    if (!msg_buffer) {
        ESP_LOGE(TAG, "❌ Kunne ikke allokere buffer for ESP-NOW kommando");
        return false;
    }
    
    // Bygg kommando-melding
    command_msg_t *cmd_msg = (command_msg_t *)msg_buffer;
    cmd_msg->system_id = current_system_id;
    cmd_msg->msg_type = MSG_COMMAND;
    memcpy(cmd_msg->target_mac, mac, 6);
    cmd_msg->command_type = cmd_type;
    
    // Kopier data hvis det finnes
    if (data && data_len > 0) {
        memcpy(cmd_msg->data, data, data_len);
    }
    
    ESP_LOGI(TAG, "📡 Sender ESP-NOW kommando type %d til %02x:%02x:%02x:%02x:%02x:%02x (System ID: %08X, størrelse: %zu bytes)",
             cmd_type, mac[0], mac[1], mac[2], mac[3], mac[4], mac[5], current_system_id, total_size);
    
    // Send via ESP-NOW
    esp_err_t result = esp_now_send(mac, msg_buffer, total_size);
    
    free(msg_buffer);
    
    if (result == ESP_OK) {
        ESP_LOGI(TAG, "✅ ESP-NOW kommando sendt vellykket");
        return true;
    } else {
        ESP_LOGE(TAG, "❌ ESP-NOW kommando sending feilet: %s", esp_err_to_name(result));
        return false;
    }
}

// Funksjonsdeklarasjoner for paired poles
void load_paired_poles_from_nvs(void);
void save_paired_poles_to_nvs(void);
void add_paired_pole(const uint8_t *mac, const char *name);
void remove_paired_pole(const uint8_t *mac);
esp_err_t get_paired_poles_handler(httpd_req_t *req);
esp_err_t unpair_pole_handler(httpd_req_t *req);
esp_err_t rename_pole_handler(httpd_req_t *req);

// NVS-funksjoner for passeringskonfigurasjon
esp_err_t save_passage_config_to_nvs(void);
esp_err_t load_passage_config_from_nvs(void);


esp_err_t simulate_pole_data_handler(httpd_req_t *req);
esp_err_t websocket_test_page_handler(httpd_req_t *req);
esp_err_t test_duplicate_passage_handler(httpd_req_t *req);

// Funksjonsdeklarasjoner for signal tracking
void update_signal_quality(const uint8_t *mac, int8_t rssi);
int calculate_signal_quality(int8_t rssi, uint32_t packet_loss_percent);
void init_signal_tracking(void);
esp_err_t get_signal_quality_handler(httpd_req_t *req);
esp_err_t system_status_handler(httpd_req_t *req);


// Nye funksjonsdeklarasjoner for debounce-håndtering
bool should_ignore_break(const uint8_t *mac, int32_t sensor_id, uint32_t time_sec, uint32_t time_micros);
//void send_break_to_websocket(const uint8_t *mac_addr, uint32_t time_sec, uint32_t time_micros, int32_t sensor_id, bool filtered);
void send_break_to_websocket(const uint8_t *mac_addr, uint32_t time_sec, uint32_t time_micros, 
                             int32_t sensor_id, int32_t break_state, bool filtered);
//bool process_break_for_passage_detection(const uint8_t *mac_addr, int32_t sensor_id, uint32_t time_sec, uint32_t time_micros);
bool process_break_for_passage_detection(const uint8_t *mac_addr, int32_t sensor_id, 
                                        uint32_t sensor_time_sec, uint32_t sensor_time_micros,
                                        uint32_t server_time_sec, uint32_t server_time_micros);



int8_t get_tcp_client_rssi(int sock);


void clean_old_signal_tracking(void *pvParameters);


// Hjelpefunksjon for å estimere TCP-klient RSSI
int8_t get_tcp_client_rssi(int sock) {
    // Få klient-adresse
    struct sockaddr_storage client_addr;
    socklen_t addr_len = sizeof(client_addr);
    
    if (getpeername(sock, (struct sockaddr *)&client_addr, &addr_len) == 0) {
        // For WiFi-tilkoblinger kan vi prøve å hente faktisk RSSI
        // Men dette krever mer kompleks implementasjon med WiFi stack
        // For nå returnerer vi en estimert verdi basert på TCP-tilkobling
        return -25; // Ganske sterkt signal siden TCP fungerer
    }
    
    return -40; // Fallback-verdi
}


// Funksjon for å legge til passering i historikk
void add_to_passage_history(const uint8_t *mac, uint32_t time_sec, uint32_t time_usec, 
                           int *sensor_ids, int sensor_count) {


    xSemaphoreTake(passage_history_mutex, portMAX_DELAY);
    
    // Beregn tid siden forrige passering
    uint32_t time_since_previous_ms = 0;
    if (passage_history_count > 0) {
        uint64_t current_time_ms = (uint64_t)time_sec * 1000 + time_usec / 1000;
        uint64_t last_time_ms = (uint64_t)passage_history[0].timestamp_sec * 1000 + 
                               passage_history[0].timestamp_usec / 1000;
        time_since_previous_ms = (uint32_t)(current_time_ms - last_time_ms);
    }
    
    // Flytt eksisterende data ned
    for (int i = MIN(passage_history_count, MAX_PASSAGE_HISTORY - 1); i > 0; i--) {
        passage_history[i] = passage_history[i-1];
    }
    
    // Legg til ny passering øverst
    memcpy(passage_history[0].mac, mac, ESP_NOW_ETH_ALEN);
    passage_history[0].timestamp_sec = time_sec;
    passage_history[0].timestamp_usec = time_usec;
    passage_history[0].sensors_count = sensor_count;
    passage_history[0].time_since_previous_ms = time_since_previous_ms;
    
    for (int i = 0; i < sensor_count && i < MAX_SENSORS_PER_POLE; i++) {
        passage_history[0].sensor_ids[i] = sensor_ids[i];
    }
    
    if (passage_history_count < MAX_PASSAGE_HISTORY) {
        passage_history_count++;
    }
    total_passages++;
    
    xSemaphoreGive(passage_history_mutex);
}



// Nye funksjonsdeklarasjoner for håndtering av sendte passeringer
//bool is_passage_already_sent(const uint8_t *mac, uint32_t time_sec, uint32_t time_micros, int sensors_count);
void register_sent_passage(const uint8_t *mac, uint32_t time_sec, uint32_t time_micros, int sensors_count);
//bool check_and_register_passage_atomic(const uint8_t *mac, uint32_t time_sec, uint32_t time_micros, int sensors_count);
void clean_old_passages(void *pvParameters);

// Nye funksjonsdeklarasjoner for dual-timing stoppeklokke
void register_passage_for_stopwatch(const uint8_t *mac_addr, uint32_t server_sec, uint32_t server_usec,
                                   uint32_t pole_sec, uint32_t pole_usec, int sensor_count);
void log_passage_with_dual_timing(const char *mac_str, int sensor_id,
                                 uint32_t pole_time_sec, uint32_t pole_time_usec,
                                 uint32_t server_time_sec, uint32_t server_time_usec,
                                 int *sensors_used, int sensor_count);
uint64_t calculate_stopwatch_time_ms(const uint8_t *mac1, const uint8_t *mac2);

// bool check_register_and_send_passage_atomic(const uint8_t *mac, uint32_t time_sec, 
//                                            uint32_t time_micros, int sensors_count,
//                                            const char *mac_str);


// Nye funksjonsdeklarasjoner for discovery og pairing
void handle_pole_announce(const pole_announce_t *announce, int8_t rssi);
void add_or_update_discovered_pole(const pole_announce_t *announce, int8_t rssi);
void send_discovery_update_to_gui(void);
void initialize_system_id(void);
bool send_system_assign_to_pole(const uint8_t *mac);
esp_err_t get_discovered_poles_handler(httpd_req_t *req);
esp_err_t assign_pole_handler(httpd_req_t *req);
esp_err_t identify_pole_handler(httpd_req_t *req);
esp_err_t get_system_id_handler(httpd_req_t *req);
bool is_paired_pole_by_mac(const uint8_t *mac);


static httpd_handle_t global_server = NULL;
static httpd_handle_t server = NULL;
static int ws_clients[MAX_WS_CLIENTS];
static SemaphoreHandle_t ws_mutex;


//
//
//--------------- Del 2: Hjelpefunksjoner for filsystem og TCP-kommunikasjon ----------------
//
//









// Legg til en hjelpefunksjon for å liste filer i SPIFFS
void list_spiffs_files(const char *path) {
    DIR *dir = opendir(path);
    if (!dir) {
        ESP_LOGE(TAG, "Failed to open directory %s (errno: %d)", path, errno);
        return;
    }
    
    struct dirent *entry;
    while ((entry = readdir(dir)) != NULL) {
        // Bygg full filbane
        char full_path[FILE_PATH_MAX];
        if (snprintf(full_path, sizeof(full_path), "%s/%s", path, entry->d_name) >= sizeof(full_path)) {
            ESP_LOGE(TAG, "Path too long: %s/%s", path, entry->d_name);
            continue;
        }
        
        // Sjekk filtype
        struct stat st;
        if (stat(full_path, &st) == 0) {
            if (S_ISDIR(st.st_mode)) {
                ESP_LOGI(TAG, "  Dir: %s", full_path);
                // Sjekk undermapper rekursivt
                list_spiffs_files(full_path);
            } else {
                ESP_LOGI(TAG, "  File: %s (Size: %ld bytes)", full_path, st.st_size);
            }
        } else {
            ESP_LOGE(TAG, "  Failed to stat: %s (errno: %d)", full_path, errno);
        }
    }
    closedir(dir);
}

// Funksjon for å sende kommando til en spesifikk målestolpe basert på MAC-adresse
bool send_command_to_pole_by_mac(const char *mac, const char *command) {
    bool sent = false;
    xSemaphoreTake(tcp_poles_mutex, portMAX_DELAY);
    
    // Sjekk først for eksakt match på MAC-adresse eller nominell MAC
    for (int i = 0; i < MAX_TCP_POLES; i++) {
        if (tcp_poles[i].connected && 
           (strcmp(tcp_poles[i].mac, mac) == 0 || 
            (strlen(tcp_poles[i].nominal_mac) > 0 && strcmp(tcp_poles[i].nominal_mac, mac) == 0))) {
            
            int sock = tcp_poles[i].sock;
            int to_write = strlen(command);
            int res = send(sock, command, to_write, 0);
            
            if (res == to_write) {
                ESP_LOGI(TAG, "Kommando sendt til målestolpe %d (MAC: %s): %s", 
                          i, tcp_poles[i].nominal_mac[0] ? tcp_poles[i].nominal_mac : mac, command);
                sent = true;
            } else {
                ESP_LOGE(TAG, "Feil ved sending av kommando: %d (errno: %d)", res, errno);
            }
            break;
        }
    }
    
    // Hvis ingen match, og dette er første gang vi ser denne MAC-adressen,
    // tildel den til første ledige målestolpe uten nominal_mac
    if (!sent) {
        for (int i = 0; i < MAX_TCP_POLES; i++) {
            if (tcp_poles[i].connected && strlen(tcp_poles[i].nominal_mac) == 0) {
                // Lagre den nominelle MAC-adressen
                strncpy(tcp_poles[i].nominal_mac, mac, sizeof(tcp_poles[i].nominal_mac) - 1);
                tcp_poles[i].nominal_mac[sizeof(tcp_poles[i].nominal_mac) - 1] = '\0'; // Sikre null-terminering
                
                ESP_LOGI(TAG, "Tildelt nominell MAC: %s til målestolpe %d", mac, i);
                
                int sock = tcp_poles[i].sock;
                int to_write = strlen(command);
                int res = send(sock, command, to_write, 0);
                
                if (res == to_write) {
                    ESP_LOGI(TAG, "Kommando sendt til målestolpe %d med nylig tildelt nominell MAC: %s: %s", 
                             i, mac, command);
                    sent = true;
                } else {
                    ESP_LOGE(TAG, "Feil ved sending av kommando: %d (errno: %d)", res, errno);
                }
                break;
            }
        }
    }
    
    // Siste utvei: Send til første tilkoblede målestolpe hvis ingen har fått tildelt MAC
    if (!sent) {
        for (int i = 0; i < MAX_TCP_POLES; i++) {
            if (tcp_poles[i].connected) {
                int sock = tcp_poles[i].sock;
                int to_write = strlen(command);
                int res = send(sock, command, to_write, 0);
                
                if (res == to_write) {
                    ESP_LOGI(TAG, "Siste utvei: Kommando sendt til første tilkoblede målestolpe %d (søkt MAC: %s): %s", 
                             i, mac, command);
                    
                    // Tildel MAC-adressen til denne målestolpen for fremtidige kall
                    strncpy(tcp_poles[i].nominal_mac, mac, sizeof(tcp_poles[i].nominal_mac) - 1);
                    tcp_poles[i].nominal_mac[sizeof(tcp_poles[i].nominal_mac) - 1] = '\0'; // Sikre null-terminering
                    
                    ESP_LOGI(TAG, "Tildelt nominell MAC: %s til målestolpe %d", mac, i);
                    
                    sent = true;
                } else {
                    ESP_LOGE(TAG, "Feil ved sending av kommando: %d (errno: %d)", res, errno);
                }
                break;
            }
        }
    }
    
    xSemaphoreGive(tcp_poles_mutex);
    
    if (!sent) {
        ESP_LOGW(TAG, "Fant ingen tilkoblet målestolpe å sende til med MAC: %s", mac);
    }
    
    return sent;
}


esp_err_t init_fs(void) {
    ESP_LOGI(TAG, "Mounting SPIFFS with base_path=/www, partition_label=www");
    
    esp_vfs_spiffs_conf_t conf = {
        .base_path = "/www",
        .partition_label = "www",
        .max_files = 20,  // Økt fra 5 til 10 for å støtte flere filer
        .format_if_mount_failed = false
    };
    
    esp_err_t ret = esp_vfs_spiffs_register(&conf);
    if (ret != ESP_OK) {
        if (ret == ESP_FAIL) {
            ESP_LOGE(TAG, "Failed to mount or format filesystem (ESP_FAIL)");
        } else if (ret == ESP_ERR_NOT_FOUND) {
            ESP_LOGE(TAG, "Failed to find SPIFFS partition (ESP_ERR_NOT_FOUND)");
        } else {
            ESP_LOGE(TAG, "Failed to initialize SPIFFS (%s)", esp_err_to_name(ret));
        }
        return ESP_FAIL;
    }
    
    size_t total = 0, used = 0;
    ret = esp_spiffs_info(conf.partition_label, &total, &used);
    if (ret != ESP_OK) {
        ESP_LOGE(TAG, "Failed to get SPIFFS partition information (%s)", esp_err_to_name(ret));
    } else {
        ESP_LOGI(TAG, "Partition size: total: %d, used: %d", total, used);
    }
    
    // List alle filer i SPIFFS
    ESP_LOGI(TAG, "Listing all files in SPIFFS:");
    list_spiffs_files("/www");
    
    return ESP_OK;
}


// 
// 
//--------------- Del 3: TCP Server og Client Handler ---------------- 
// 
//
// Funksjon som håndterer en målestolpes TCP-forbindelse
// Funksjon som håndterer en målestolpes TCP-forbindelse
void tcp_client_handler(void *arg) {
    int sock = *(int *)arg;
    free(arg); // Frigjør minneallokeringen fra TCP server task
    
    char rx_buffer[100];
    char command[140];
    int cmd_index = 0;
    int pole_idx = -1;

    // Finn en ledig plass i tcp_poles-arrayet
    xSemaphoreTake(tcp_poles_mutex, portMAX_DELAY);
    for (int i = 0; i < MAX_TCP_POLES; i++) {
        if (!tcp_poles[i].connected) {
            tcp_poles[i].connected = true;
            tcp_poles[i].sock = sock;
            // Initialiser nominal_mac til tom streng
            tcp_poles[i].nominal_mac[0] = '\0';
            
            // Forsøk å hente IP-adressen til den tilkoblede klienten
            struct sockaddr_storage source_addr;
            socklen_t addr_len = sizeof(source_addr);
            if (getpeername(sock, (struct sockaddr *)&source_addr, &addr_len) == 0) {
                char ip_str[INET_ADDRSTRLEN];
                struct sockaddr_in *source = (struct sockaddr_in *)&source_addr;
                inet_ntop(AF_INET, &(source->sin_addr), ip_str, INET_ADDRSTRLEN);
                
                ESP_LOGI(TAG, "Målestolpe på indeks %d har IP: %s", i, ip_str);
            }
            
            pole_idx = i;
            break;
        }
    }
    xSemaphoreGive(tcp_poles_mutex);

    if (pole_idx == -1) {
        ESP_LOGE(TAG, "Ingen ledige plasser for målestolper, avviser forbindelse");
        close(sock);
        vTaskDelete(NULL);
        return;
    }

    ESP_LOGI(TAG, "Målestolpe tilkoblet på indeks %d, socket %d", pole_idx, sock);

    while (1) {
        vTaskDelay(10 / portTICK_PERIOD_MS);
        int len = recv(sock, rx_buffer, sizeof(rx_buffer) - 1, MSG_DONTWAIT);
        if (len < 0) {
            if (errno == 128 || errno == ENOTCONN) {
                ESP_LOGE(TAG, "Målestolpe har koblet fra: errno %d", errno);
                break;
            }
        } else if (len == 0) {
            ESP_LOGW(TAG, "Forbindelse lukket");
            break;
        } else {
            rx_buffer[len] = 0; // Null-terminer strengen
            
            // Prosesser mottatte data
            for (int i = 0; i < len; i++) {
                command[cmd_index] = rx_buffer[i];
                if (rx_buffer[i] == '\n') {
                    command[cmd_index] = 0; // Null-terminer kommandostrengen
                    
                    // Sjekk om dette er et break-event
                    if (strncmp(command, "break:", 6) == 0) {
                        // Parse sensor_id og break_state
                        int sensor_id = 0;
                        int break_state = 0;
                        if (sscanf(command + 6, "%d %d", &sensor_id, &break_state) == 2) {
                            // Få gjeldende tid
                            struct timeval tv;
                            gettimeofday(&tv, NULL);
                            
                            // Send alltid rådata (ufiltrert)
                            uint8_t mac_bytes[ESP_NOW_ETH_ALEN];
                            // Konverterer mac-stringen til bytes hvis nødvendig
                            // For enkelhets skyld bruker vi bare pole_idx her
                            mac_bytes[0] = 0xAA; // Dummy MAC for TCP-sensorer
                            mac_bytes[1] = 0xBB;
                            mac_bytes[2] = 0xCC;
                            mac_bytes[3] = 0xDD;
                            mac_bytes[4] = 0xEE;
                            mac_bytes[5] = pole_idx & 0xFF; // Bruk pole_idx som siste byte
                            
                            //send_break_to_websocket(mac_bytes, tv.tv_sec, tv.tv_usec, break_state, false);
                            send_break_to_websocket(mac_bytes, tv.tv_sec, tv.tv_usec, sensor_id, break_state, false);

                            // Behandle brudd for passeringsdeteksjon
                            struct timeval tv_now;
                            gettimeofday(&tv_now, NULL);
                            process_break_for_passage_detection(mac_bytes, sensor_id, 
                                                            tv.tv_sec, tv.tv_usec,           // Målestolpe-tid
                                                            tv_now.tv_sec, tv_now.tv_usec); // Server-tid
                        }
                    }
                   
                   



                    // Registrer målestolpen som ESP-NOW peer når vi får MAC-adressen
                    if (strncmp(command, "ID: ", 4) == 0) {
                        strncpy(tcp_poles[pole_idx].mac, command + 4, 17);
                        tcp_poles[pole_idx].mac[17] = 0; // Sikre null-terminering
                        ESP_LOGI(TAG, "Målestolpe %d har MAC: '%s'", pole_idx, tcp_poles[pole_idx].mac);
                        
                        // Automatisk registrering som ESP-NOW peer
                        uint8_t mac_bytes[6];
                        if (sscanf(tcp_poles[pole_idx].mac, "%hhx:%hhx:%hhx:%hhx:%hhx:%hhx", 
                                  &mac_bytes[0], &mac_bytes[1], &mac_bytes[2],
                                  &mac_bytes[3], &mac_bytes[4], &mac_bytes[5]) == 6) {
                            
                            esp_now_peer_info_t peer_info = {0};
                            memcpy(peer_info.peer_addr, mac_bytes, ESP_NOW_ETH_ALEN);
                            peer_info.channel = 0;
                            peer_info.ifidx = WIFI_IF_AP;
                            peer_info.encrypt = false;
                            
                            // Sjekk først om peer allerede eksisterer
                            if (!esp_now_is_peer_exist(mac_bytes)) {
                                esp_err_t peer_result = esp_now_add_peer(&peer_info);
                                if (peer_result == ESP_OK) {
                                    ESP_LOGI(TAG, "✅ TCP-målestolpe registrert som ESP-NOW peer: %s", tcp_poles[pole_idx].mac);
                                } else {
                                    ESP_LOGE(TAG, "❌ Kunne ikke registrere TCP-målestolpe som ESP-NOW peer: %s (%s)", 
                                            tcp_poles[pole_idx].mac, esp_err_to_name(peer_result));
                                }
                            } else {
                                ESP_LOGI(TAG, "ℹ️ TCP-målestolpe allerede registrert som ESP-NOW peer: %s", tcp_poles[pole_idx].mac);
                            }
                        }
                    }


                    
                    // Send direkte til WebSocket-klienter
                    char ws_msg[256];
                    if (command[0] == '{' && strchr(command, '}')) {
                        // Kommandoen er allerede i JSON-format, send direkte
                        strncpy(ws_msg, command, sizeof(ws_msg) - 1);
                        ws_msg[sizeof(ws_msg) - 1] = '\0'; // Sikre null-terminering
                    } else {
                        // Ikke JSON-format, pakk inn kommandoen
                        sprintf(ws_msg, "{\"M\":\"%s\",\"K\":3,\"cmd\":\"%s\"}", 
                                tcp_poles[pole_idx].mac, command);
                    }
                    


                    // Oppdater signal tracking for TCP-tilkobling
                    if (strlen(tcp_poles[pole_idx].mac) > 0) {
                        uint8_t mac_bytes[ESP_NOW_ETH_ALEN];
                        if (sscanf(tcp_poles[pole_idx].mac, "%hhx:%hhx:%hhx:%hhx:%hhx:%hhx", 
                                  &mac_bytes[0], &mac_bytes[1], &mac_bytes[2],
                                  &mac_bytes[3], &mac_bytes[4], &mac_bytes[5]) == 6) {
                            
                            // int8_t tcp_rssi = get_tcp_client_rssi(sock);
                            // update_signal_quality(mac_bytes, tcp_rssi);
                            
                            // ESP_LOGD(TAG, "📶 TCP Signal oppdatert for %s - RSSI: %d dBm", 
                            //         tcp_poles[pole_idx].mac, tcp_rssi);
                        }
                    }




                    // Send til alle WebSocket-klienter
                    httpd_ws_frame_t ws_pkt = {
                        .final = true,
                        .fragmented = false,
                        .type = HTTPD_WS_TYPE_TEXT,
                        .payload = (uint8_t *)ws_msg,
                        .len = strlen(ws_msg)
                    };

                    xSemaphoreTake(ws_mutex, portMAX_DELAY);
                    for (int i = 0; i < MAX_WS_CLIENTS; ++i) {
                        if (ws_clients[i] != 0) {
                            httpd_ws_send_frame_async(server, ws_clients[i], &ws_pkt);
                        }
                    }
                    xSemaphoreGive(ws_mutex);
                    
                    cmd_index = 0;
                } else {
                    cmd_index++;
                    if (cmd_index >= sizeof(command) - 1) {
                        cmd_index = 0; // Unngå buffer overflow
                    }
                }
            }
        }
        
        // Håndtere utgående kommandoer vil bli implementert senere
    }

    // Lukk forbindelsen når løkken avsluttes
    xSemaphoreTake(tcp_poles_mutex, portMAX_DELAY);
    tcp_poles[pole_idx].connected = false;
    
    // Logg MAC-adressen som ble frakoblet, men behold den for debugging
    if (strlen(tcp_poles[pole_idx].nominal_mac) > 0) {
        ESP_LOGI(TAG, "Målestolpe %d med nominell MAC: %s koblet fra", 
                 pole_idx, tcp_poles[pole_idx].nominal_mac);
    }
    
    // Behold nominal_mac for debugging, men sett mac til tom
    tcp_poles[pole_idx].mac[0] = '\0';
    xSemaphoreGive(tcp_poles_mutex);
    
    close(sock);
    ESP_LOGI(TAG, "Målestolpe %d koblet fra, frigjort", pole_idx);
    vTaskDelete(NULL);
}







// TCP-server som lytter etter innkommende forbindelser
static void tcp_server_task(void *pvParameters) {
    char addr_str[128];
    int addr_family = AF_INET;
    int ip_protocol = 0;
    int keepAlive = 1;
    int keepIdle = KEEPALIVE_IDLE;
    int keepInterval = KEEPALIVE_INTERVAL;
    int keepCount = KEEPALIVE_COUNT;
    struct sockaddr_storage dest_addr;

    struct sockaddr_in *dest_addr_ip4 = (struct sockaddr_in *)&dest_addr;
    dest_addr_ip4->sin_addr.s_addr = htonl(INADDR_ANY);
    dest_addr_ip4->sin_family = AF_INET;
    dest_addr_ip4->sin_port = htons(PORT);
    ip_protocol = IPPROTO_IP;

    int listen_sock = socket(addr_family, SOCK_STREAM, ip_protocol);
    if (listen_sock < 0) {
        ESP_LOGE(TAG, "Kunne ikke opprette socket: errno %d", errno);
        vTaskDelete(NULL);
        return;
    }
    int opt = 1;
    setsockopt(listen_sock, SOL_SOCKET, SO_REUSEADDR, &opt, sizeof(opt));

    ESP_LOGI(TAG, "Socket opprettet");

    int err = bind(listen_sock, (struct sockaddr *)&dest_addr, sizeof(dest_addr));
    if (err != 0) {
        ESP_LOGE(TAG, "Socket kunne ikke bindes: errno %d", errno);
        goto CLEAN_UP;
    }
    ESP_LOGI(TAG, "Socket bundet, port %d", PORT);

    err = listen(listen_sock, 2);
    if (err != 0) {
        ESP_LOGE(TAG, "Feil under lytting: errno %d", errno);
        goto CLEAN_UP;
    }

    while (1) {
        ESP_LOGI(TAG, "TCP-server lytter på port %d...", PORT);

        struct sockaddr_storage source_addr;
        socklen_t addr_len = sizeof(source_addr);
        int sock = accept(listen_sock, (struct sockaddr *)&source_addr, &addr_len);
        if (sock < 0) {
            ESP_LOGE(TAG, "Kunne ikke akseptere forbindelse: errno %d", errno);
            break;
        }

        // Sett TCP keepalive
        setsockopt(sock, SOL_SOCKET, SO_KEEPALIVE, &keepAlive, sizeof(int));
        setsockopt(sock, IPPROTO_TCP, TCP_KEEPIDLE, &keepIdle, sizeof(int));
        setsockopt(sock, IPPROTO_TCP, TCP_KEEPINTVL, &keepInterval, sizeof(int));
        setsockopt(sock, IPPROTO_TCP, TCP_KEEPCNT, &keepCount, sizeof(int));
        
        // Konverter IP-adresse til streng
        if (source_addr.ss_family == PF_INET) {
            inet_ntoa_r(((struct sockaddr_in *)&source_addr)->sin_addr, addr_str, sizeof(addr_str) - 1);
        }
        ESP_LOGI(TAG, "Socket akseptert, IP-adresse: %s", addr_str);

        // Opprett en ny task for å håndtere klienten
        int *socket_ptr = malloc(sizeof(int));
        if (socket_ptr == NULL) {
            ESP_LOGE(TAG, "Feil ved allokering av socket_ptr");
            close(sock);
            continue;
        }
        *socket_ptr = sock;
        xTaskCreatePinnedToCore(tcp_client_handler, "tcp_client_handler", 4096, socket_ptr, 5, NULL, 1);
    }

CLEAN_UP:
    close(listen_sock);
    vTaskDelete(NULL);
}


// 
// 
//--------------- Del 4: API Handlers (oppdaterte versjoner) ---------------- 
// 
// 

// Renset versjon av pole_restart_handler - kun ESP-NOW, ingen TCP warnings
esp_err_t pole_restart_handler(httpd_req_t *req) {
    char buf[100];
    int ret, remaining = req->content_len;
    
    ESP_LOGI(TAG, "pole_restart_handler called, content_len: %d", remaining);
    
    // Legg til CORS-headere
    httpd_resp_set_hdr(req, "Access-Control-Allow-Origin", "*");
    
    // Hvis dette er en OPTIONS forespørsel, bare returner 200 OK med CORS-headere
    if (req->method == HTTP_OPTIONS) {
        httpd_resp_send(req, NULL, 0);
        return ESP_OK;
    }
    
    if (remaining > sizeof(buf)) {
        httpd_resp_send_err(req, HTTPD_500_INTERNAL_SERVER_ERROR, "Request too large");
        return ESP_FAIL;
    }
    
    if ((ret = httpd_req_recv(req, buf, MIN(remaining, sizeof(buf)))) <= 0) {
        if (ret == HTTPD_SOCK_ERR_TIMEOUT) {
            httpd_resp_send_408(req);
        }
        return ESP_FAIL;
    }
    
    buf[ret] = '\0';
    ESP_LOGI(TAG, "Mottok data: %s", buf);
    
    // Parse JSON data for MAC-adresse
    char mac[18] = {0};
    char *mac_start = strstr(buf, "\"mac\":\"");
    if (mac_start) {
        mac_start += 7; // Hopp over "mac":"
        char *mac_end = strchr(mac_start, '"');
        if (mac_end && (mac_end - mac_start) < 18) {
            strncpy(mac, mac_start, mac_end - mac_start);
            mac[mac_end - mac_start] = '\0';
        }
    }
    
    // Parse restart-type (hvis angitt)
    int restart_type = 1;  // Standard: soft restart
    char *type_start = strstr(buf, "\"type\":");
    if (type_start) {
        type_start += 7; // Hopp over "type":
        restart_type = atoi(type_start);
    }
    
    ESP_LOGI(TAG, "Restart forespørsel for MAC: %s, type: %d", mac, restart_type);
    
    bool success = false;
    
    if (strlen(mac) > 0) {
        // Send restart-kommando via ESP-NOW
        ESP_LOGI(TAG, "🔄 Sender restart-kommando via ESP-NOW (MAC: %s, type: %d)", 
                 mac, restart_type);
        
        // Konverter MAC-streng til bytes
        uint8_t target_mac[6];
        
        if (sscanf(mac, "%hhx:%hhx:%hhx:%hhx:%hhx:%hhx", 
                  &target_mac[0], &target_mac[1], &target_mac[2],
                  &target_mac[3], &target_mac[4], &target_mac[5]) == 6) {
            
            uint8_t restart_cmd_type;
            const char* restart_type_name;
            
            switch (restart_type) {
                case 1:
                    restart_cmd_type = CMD_RESTART_SOFT;
                    restart_type_name = "Soft restart";
                    break;
                case 2:
                    restart_cmd_type = CMD_RESTART_HARD;
                    restart_type_name = "Hard restart";
                    break;
                case 3:
                    restart_cmd_type = CMD_RESTART_FACTORY;
                    restart_type_name = "Factory reset";
                    break;
                default:
                    restart_cmd_type = CMD_RESTART_SOFT;
                    restart_type_name = "Soft restart (default)";
                    break;
            }
            
            success = send_esp_now_command_to_pole(
                target_mac, 
                restart_cmd_type, 
                NULL, 
                0  // Ingen ekstra data trengs
            );
            
            if (success) {
                ESP_LOGI(TAG, "✅ ESP-NOW restart-kommando sendt til %s (%s)", mac, restart_type_name);
            } else {
                ESP_LOGE(TAG, "❌ ESP-NOW restart-kommando feilet for %s (%s)", mac, restart_type_name);
            }
        } else {
            ESP_LOGW(TAG, "Ugyldig MAC-format: %s", mac);
        }
    } else {
        ESP_LOGW(TAG, "Ingen MAC-adresse angitt i restart-forespørsel");
    }
    
    // TCP-kode er helt fjernet - kun ESP-NOW i bruk
    
    httpd_resp_set_type(req, "application/json");
    httpd_resp_set_hdr(req, "Access-Control-Allow-Origin", "*");
    
    if (success) {
        httpd_resp_sendstr(req, "{\"status\":\"success\",\"message\":\"Restart command sent via ESP-NOW\"}");
    } else {
        httpd_resp_sendstr(req, "{\"status\":\"error\",\"message\":\"Failed to send restart command\"}");
    }
    
    return ESP_OK;
}



// ================== POLE_POWER_HANDLER - REN ESP-NOW VERSJON ==================
esp_err_t pole_power_handler(httpd_req_t *req) {
    char buf[100];
    int ret, remaining = req->content_len;
    
    ESP_LOGI(TAG, "pole_power_handler called, content_len: %d", remaining);
    
    // Legg til CORS-headere
    httpd_resp_set_hdr(req, "Access-Control-Allow-Origin", "*");
    
    // Hvis dette er en OPTIONS forespørsel, bare returner 200 OK med CORS-headere
    if (req->method == HTTP_OPTIONS) {
        httpd_resp_send(req, NULL, 0);
        return ESP_OK;
    }
    
    if (remaining > sizeof(buf)) {
        httpd_resp_send_err(req, HTTPD_500_INTERNAL_SERVER_ERROR, "Request too large");
        return ESP_FAIL;
    }
    
    if ((ret = httpd_req_recv(req, buf, MIN(remaining, sizeof(buf)))) <= 0) {
        if (ret == HTTPD_SOCK_ERR_TIMEOUT) {
            httpd_resp_send_408(req);
        }
        return ESP_FAIL;
    }
    
    buf[ret] = '\0';
    ESP_LOGI(TAG, "Mottok data: %s", buf);
    
    // Parse JSON data for MAC-adresse og strømtilstand
    char mac[18] = {0};
    char power_state[4] = {0};  // "on" eller "off"
    
    // Hent MAC-adresse
    char *mac_start = strstr(buf, "\"mac\":\"");
    if (mac_start) {
        mac_start += 7; // Hopp over "mac":"
        char *mac_end = strchr(mac_start, '"');
        if (mac_end && (mac_end - mac_start) < 18) {
            strncpy(mac, mac_start, mac_end - mac_start);
            mac[mac_end - mac_start] = '\0';
        }
    }
    
    // Hent strømtilstand
    char *power_start = strstr(buf, "\"power\":\"");
    if (power_start) {
        power_start += 9; // Hopp over "power":"
        char *power_end = strchr(power_start, '"');
        if (power_end && (power_end - power_start) < 4) {
            strncpy(power_state, power_start, power_end - power_start);
            power_state[power_end - power_start] = '\0';
        }
    }
    
    ESP_LOGI(TAG, "Strømkontroll for MAC: %s, tilstand: %s", mac, power_state);
    
    bool success = false;
    
    if (strlen(mac) > 0 && strlen(power_state) > 0) {
        // Send power-kommando via ESP-NOW
        ESP_LOGI(TAG, "🔋 Sender power-kommando via ESP-NOW (MAC: %s, tilstand: %s)", 
                 mac, power_state);
        
        // Konverter MAC-streng til bytes
        uint8_t target_mac[6];
        
        if (sscanf(mac, "%hhx:%hhx:%hhx:%hhx:%hhx:%hhx", 
                  &target_mac[0], &target_mac[1], &target_mac[2],
                  &target_mac[3], &target_mac[4], &target_mac[5]) == 6) {
            
            uint8_t power_cmd_type;
            const char* power_description;
            
            if (strcmp(power_state, "on") == 0) {
                power_cmd_type = CMD_POWER_ON;
                power_description = "Våkn fra deep sleep";
            } else if (strcmp(power_state, "off") == 0) {
                power_cmd_type = CMD_POWER_OFF;
                power_description = "Gå til deep sleep";
            } else {
                ESP_LOGW(TAG, "Ugyldig power-tilstand: %s (forventet 'on' eller 'off')", power_state);
                power_cmd_type = 0; // Ugyldig
                power_description = "Ugyldig kommando";
            }
            
            if (power_cmd_type != 0) {
                success = send_esp_now_command_to_pole(
                    target_mac, 
                    power_cmd_type, 
                    NULL, 
                    0  // Ingen ekstra data trengs
                );
                
                if (success) {
                    ESP_LOGI(TAG, "✅ ESP-NOW power-kommando sendt til %s (%s)", mac, power_description);
                    
                    // Spesiell logging for power off siden målestolpen vil sove
                    if (strcmp(power_state, "off") == 0) {
                        ESP_LOGI(TAG, "💤 Målestolpe %s går til deep sleep og vil ikke svare før manuell oppstart", mac);
                    }
                } else {
                    ESP_LOGE(TAG, "❌ ESP-NOW power-kommando feilet for %s (%s)", mac, power_description);
                }
            }
        } else {
            ESP_LOGW(TAG, "Ugyldig MAC-format: %s", mac);
        }
    } else {
        ESP_LOGW(TAG, "Ugyldig forespørsel - MAC: %s, power_state: %s", mac, power_state);
    }
    
    // TCP-kode er helt fjernet - kun ESP-NOW i bruk
    
    httpd_resp_set_type(req, "application/json");
    httpd_resp_set_hdr(req, "Access-Control-Allow-Origin", "*");
    
    if (success) {
        char response_msg[128];
        if (strcmp(power_state, "off") == 0) {
            sprintf(response_msg, "Power OFF command sent via ESP-NOW - device will enter deep sleep");
        } else {
            sprintf(response_msg, "Power %s command sent via ESP-NOW", power_state);
        }
        
        char json_response[256];
        sprintf(json_response, "{\"status\":\"success\",\"message\":\"%.120s\"}", response_msg);
        httpd_resp_sendstr(req, json_response);
    } else {
        httpd_resp_sendstr(req, "{\"status\":\"error\",\"message\":\"Failed to send power command\"}");
    }
    
    return ESP_OK;
}



// Funksjon for å håndtere tid-synkronisering API (oppdatert versjon)
esp_err_t time_sync_handler(httpd_req_t *req) {
    char buf[100];
    int ret, remaining = req->content_len;
    
    ESP_LOGI(TAG, "time_sync_handler called, content_len: %d", remaining);
    
    // Legg til CORS-headere først
    httpd_resp_set_hdr(req, "Access-Control-Allow-Origin", "*");
    //httpd_resp_set_hdr(req, "Access-Control-Allow-Methods", "GET, POST, OPTIONS");
    //httpd_resp_set_hdr(req, "Access-Control-Allow-Headers", "Content-Type, Accept");
    
    // Hvis dette er en OPTIONS forespørsel (preflight), bare returner 200 OK med CORS-headere
    if (req->method == HTTP_OPTIONS) {
        httpd_resp_send(req, NULL, 0);
        return ESP_OK;
    }
    
    if (remaining > sizeof(buf)) {
        httpd_resp_send_err(req, HTTPD_500_INTERNAL_SERVER_ERROR, "Request too large");
        return ESP_FAIL;
    }
    
    if ((ret = httpd_req_recv(req, buf, MIN(remaining, sizeof(buf)))) <= 0) {
        if (ret == HTTPD_SOCK_ERR_TIMEOUT) {
            httpd_resp_send_408(req);
        }
        return ESP_FAIL;
    }
    
    buf[ret] = '\0';
    ESP_LOGI(TAG, "Mottok data: %s", buf);
    
    // Parse JSON data for timestamp
    int timestamp = 0;
    char *timestamp_start = strstr(buf, "\"timestamp\":");
    if (timestamp_start) {
        timestamp_start += 12; // Hopp over "timestamp":
        timestamp = atoi(timestamp_start);
    }
    
    ESP_LOGI(TAG, "Parsed timestamp: %d", timestamp);
    
    if (timestamp > 0) {
        // Vi sender tidsynkroniseringskommando til alle tilkoblede målestolper
        

        // NYTT: Send tidsynkronisering via ESP-NOW til alle paired poles
        ESP_LOGI(TAG, "🕒 Sender tidsynkronisering via ESP-NOW til paired poles");
        
        xSemaphoreTake(paired_poles_mutex, portMAX_DELAY);
        
        // Opprett kommando-data for tidsynkronisering
        uint32_t sync_timestamp = timestamp + 1; // +1 for å kompensere for latens
        
        for (int i = 0; i < paired_pole_count; i++) {
            if (paired_poles[i].enabled) {
                bool esp_now_result = send_esp_now_command_to_pole(
                    paired_poles[i].mac, 
                    CMD_TIME_SYNC, 
                    &sync_timestamp, 
                    sizeof(sync_timestamp)
                );
                
                if (esp_now_result) {
                    ESP_LOGI(TAG, "✅ ESP-NOW tidsynkronisering sendt til %s", paired_poles[i].name);
                } else {
                    ESP_LOGW(TAG, "❌ ESP-NOW tidsynkronisering feilet for %s", paired_poles[i].name);
                }
            }
        }
        
        xSemaphoreGive(paired_poles_mutex);
        
        // Fortsett med TCP for bakoverkompatibilitet

        xSemaphoreTake(tcp_poles_mutex, portMAX_DELAY);
        
        for (int i = 0; i < MAX_TCP_POLES; i++) {
            if (tcp_poles[i].connected) {
                // Bygg kommandoen som skal sendes til målestolpen
                char command[64];
                sprintf(command, "time: %d\n", timestamp + 1); // +1 for å kompensere for noe latens
                
                // Send direkte til socket
                int sock = tcp_poles[i].sock;
                int to_write = strlen(command);
                int res = send(sock, command, to_write, 0);
                
                if (res == to_write) {
                    ESP_LOGI(TAG, "Tid synkronisert til målestolpe %d (MAC: %s): %s", 
                             i, tcp_poles[i].mac, command);
                } else {
                    ESP_LOGE(TAG, "Feil ved sending av tidskommando: %d (errno: %d)", res, errno);
                }
            }
        }
        
        xSemaphoreGive(tcp_poles_mutex);
        
        // Sett også lokal tid
        struct timeval tv;
        tv.tv_sec = timestamp;
        tv.tv_usec = 0;
        settimeofday(&tv, NULL);
        
        // Send ESP-NOW-synkronisering også (vi beholder den eksisterende funksjonaliteten)
        init_esp_now(); // Dette vil sende en synkkommando til alle ESP-NOW-enheter
    }
    
    httpd_resp_set_type(req, "application/json");
    httpd_resp_set_hdr(req, "Access-Control-Allow-Origin", "*");
    httpd_resp_sendstr(req, "{\"status\":\"success\",\"message\":\"Time synchronized\"}");
    
    return ESP_OK;
}


// Funksjon for å håndtere time/check API (beholder den eksisterende implementasjonen)
esp_err_t time_check_handler(httpd_req_t *req) {
    char buf[100];
    int ret, remaining = req->content_len;
    
    ESP_LOGI(TAG, "time_check_handler called, content_len: %d", remaining);
    
    
    // Hvis dette er en OPTIONS forespørsel, bare returner 200 OK med CORS-headere
    if (req->method == HTTP_OPTIONS) {
        httpd_resp_send(req, NULL, 0);
        return ESP_OK;
    }
    
    if (remaining > sizeof(buf)) {
        httpd_resp_send_err(req, HTTPD_500_INTERNAL_SERVER_ERROR, "Request too large");
        return ESP_FAIL;
    }
    
    if ((ret = httpd_req_recv(req, buf, MIN(remaining, sizeof(buf)))) <= 0) {
        if (ret == HTTPD_SOCK_ERR_TIMEOUT) {
            httpd_resp_send_408(req);
        }
        return ESP_FAIL;
    }
    
    buf[ret] = '\0';
    ESP_LOGI(TAG, "Mottok data: %s", buf);
    
    httpd_resp_set_type(req, "application/json");
    httpd_resp_sendstr(req, "{\"status\":\"success\",\"diff\":0}");
    
    return ESP_OK;
}


// Funksjon for å håndtere hsearch API (oppdatert for å sende til spesifikk målestolpe)
// Renset versjon av time_hsearch_handler - kun ESP-NOW, ingen TCP warnings
esp_err_t time_hsearch_handler(httpd_req_t *req) {
    char buf[100];
    int ret, remaining = req->content_len;
    
    ESP_LOGI(TAG, "time_hsearch_handler called, content_len: %d", remaining);
    
    if (remaining > sizeof(buf)) {
        httpd_resp_send_err(req, HTTPD_500_INTERNAL_SERVER_ERROR, "Request too large");
        return ESP_FAIL;
    }
    
    if ((ret = httpd_req_recv(req, buf, MIN(remaining, sizeof(buf)))) <= 0) {
        if (ret == HTTPD_SOCK_ERR_TIMEOUT) {
            httpd_resp_send_408(req);
        }
        return ESP_FAIL;
    }
    
    buf[ret] = '\0';
    ESP_LOGI(TAG, "Mottok data: %s", buf);
    
    // Parse JSON data
    int channel = 0;
    char mac[18] = {0};
    
    // Parse channel parameter
    char *channel_start = strstr(buf, "\"channel\":");
    if (channel_start) {
        channel_start += 10; // Hopp over "channel":
        channel = atoi(channel_start);
    }
    
    // Parse MAC address parameter
    char *mac_start = strstr(buf, "\"mac\":\"");
    if (mac_start) {
        mac_start += 7; // Hopp over "mac":"
        char *mac_end = strchr(mac_start, '"');
        if (mac_end && (mac_end - mac_start) < 18) {
            strncpy(mac, mac_start, mac_end - mac_start);
            mac[mac_end - mac_start] = '\0';
        }
    }
    
    ESP_LOGI(TAG, "Parsed: channel=%d, mac=\"%s\"", channel, mac);
    
    // Send hsearch via ESP-NOW
    ESP_LOGI(TAG, "🔍 Sender hsearch via ESP-NOW (channel=%d, mac=%s)", channel, mac);
    
    // Opprett kommando-data for hsearch
    uint32_t hsearch_channel = channel;
    bool success = false;
    
    if (strlen(mac) > 0) {
        // Send til spesifikk målestolpe via ESP-NOW
        uint8_t target_mac[6];
        if (sscanf(mac, "%hhx:%hhx:%hhx:%hhx:%hhx:%hhx", 
                  &target_mac[0], &target_mac[1], &target_mac[2],
                  &target_mac[3], &target_mac[4], &target_mac[5]) == 6) {
            
            success = send_esp_now_command_to_pole(
                target_mac, 
                CMD_HSEARCH, 
                &hsearch_channel, 
                sizeof(hsearch_channel)
            );
            
            if (success) {
                ESP_LOGI(TAG, "✅ ESP-NOW hsearch sendt til spesifikk målestolpe: %s", mac);
            } else {
                ESP_LOGE(TAG, "❌ ESP-NOW hsearch feilet for målestolpe: %s", mac);
            }
        }
    } else {
        // Send til alle paired poles via ESP-NOW  
        xSemaphoreTake(paired_poles_mutex, portMAX_DELAY);
        
        int sent_count = 0;
        for (int i = 0; i < paired_pole_count; i++) {
            if (paired_poles[i].enabled) {
                bool result = send_esp_now_command_to_pole(
                    paired_poles[i].mac, 
                    CMD_HSEARCH, 
                    &hsearch_channel, 
                    sizeof(hsearch_channel)
                );
                
                if (result) {
                    ESP_LOGI(TAG, "✅ ESP-NOW hsearch sendt til %s", paired_poles[i].name);
                    sent_count++;
                } else {
                    ESP_LOGE(TAG, "❌ ESP-NOW hsearch feilet for %s", paired_poles[i].name);
                }
            }
        }
        
        success = (sent_count > 0);
        ESP_LOGI(TAG, "📡 Hsearch sendt til %d av %d målestolper", sent_count, paired_pole_count);
        
        xSemaphoreGive(paired_poles_mutex);
    }
    
    // TCP-kode fjernet helt - kun ESP-NOW i bruk
    
    httpd_resp_set_type(req, "application/json");
    httpd_resp_set_hdr(req, "Access-Control-Allow-Origin", "*");
    
    if (success) {
        httpd_resp_sendstr(req, "{\"status\":\"success\",\"message\":\"Highpoint search initiated via ESP-NOW\"}");
    } else {
        httpd_resp_sendstr(req, "{\"status\":\"error\",\"message\":\"Failed to send hsearch command\"}");
    }
    
    return ESP_OK;
}



// ================== POLE_BREAK_HANDLER - REN ESP-NOW VERSJON ==================
esp_err_t pole_break_handler(httpd_req_t *req) {
    char buf[100];
    int ret, remaining = req->content_len;
    
    ESP_LOGI(TAG, "pole_break_handler called, content_len: %d", remaining);
    
    // CORS headers
    httpd_resp_set_hdr(req, "Access-Control-Allow-Origin", "*");
    
    if (req->method == HTTP_OPTIONS) {
        httpd_resp_send(req, NULL, 0);
        return ESP_OK;
    }
    
    if (remaining > sizeof(buf)) {
        httpd_resp_send_err(req, HTTPD_500_INTERNAL_SERVER_ERROR, "Request too large");
        return ESP_FAIL;
    }
    
    if ((ret = httpd_req_recv(req, buf, MIN(remaining, sizeof(buf)))) <= 0) {
        if (ret == HTTPD_SOCK_ERR_TIMEOUT) {
            httpd_resp_send_408(req);
        }
        return ESP_FAIL;
    }
    
    buf[ret] = '\0';
    ESP_LOGI(TAG, "Mottok data: %s", buf);
    
    // Parse JSON data
    char mac[18] = {0};
    int adc = -1;
    int break_val = -1;
    
    // Finn MAC-adressen i JSON-stringen
    char *mac_start = strstr(buf, "\"mac\":\"");
    if (mac_start) {
        mac_start += 7; // Hopp over "mac":"
        char *mac_end = strchr(mac_start, '"');
        if (mac_end && (mac_end - mac_start) < 18) {
            strncpy(mac, mac_start, mac_end - mac_start);
            mac[mac_end - mac_start] = '\0';
        }
    }
    
    // Finn ADC-verdien
    char *adc_start = strstr(buf, "\"adc\":");
    if (adc_start) {
        adc_start += 6; // Hopp over "adc":
        adc = atoi(adc_start);
    }
    
    // Finn break-verdien
    char *break_start = strstr(buf, "\"break\":");
    if (break_start) {
        break_start += 8; // Hopp over "break":
        break_val = atoi(break_start);
    }
    
    ESP_LOGI(TAG, "Parsed values - MAC: %s, ADC: %d, Break: %d", mac, adc, break_val);
    
    bool success = false;
    
    if (strlen(mac) > 0 && adc >= 0 && adc < 7 && break_val >= 0 && break_val < 4906) {
        // Send break-konfigurasjon via ESP-NOW
        ESP_LOGI(TAG, "🔧 Sender break-konfigurasjon via ESP-NOW (MAC: %s, ADC: %d, Break: %d)", 
                 mac, adc, break_val);
        
        // Konverter MAC-streng til bytes
        uint8_t target_mac[6];
        
        if (sscanf(mac, "%hhx:%hhx:%hhx:%hhx:%hhx:%hhx", 
                  &target_mac[0], &target_mac[1], &target_mac[2],
                  &target_mac[3], &target_mac[4], &target_mac[5]) == 6) {
            
            // Opprett kommando-data for break-konfigurasjon (tilpasset målestolpens forventede format)
            uint8_t break_data[3];
            break_data[0] = (uint8_t)adc;           // ADC nummer som uint8_t
            break_data[1] = break_val & 0xFF;       // Laveste byte av break_val
            break_data[2] = (break_val >> 8) & 0xFF; // Høyeste byte av break_val
            
            success = send_esp_now_command_to_pole(
                target_mac, 
                CMD_SET_BREAK, 
                break_data, 
                sizeof(break_data)
            );
            
            if (success) {
                ESP_LOGI(TAG, "✅ ESP-NOW break-konfigurasjon sendt til %s (ADC %d = %d)", mac, adc, break_val);
            } else {
                ESP_LOGE(TAG, "❌ ESP-NOW break-konfigurasjon feilet for %s", mac);
            }
        } else {
            ESP_LOGW(TAG, "Ugyldig MAC-format: %s", mac);
        }
    } else {
        ESP_LOGW(TAG, "Ugyldig forespørsel - MAC: %s, ADC: %d, Break: %d", mac, adc, break_val);
    }
    
    // TCP-kode er helt fjernet - kun ESP-NOW i bruk
    
    httpd_resp_set_type(req, "application/json");
    httpd_resp_set_hdr(req, "Access-Control-Allow-Origin", "*");
    
    if (success) {
        httpd_resp_sendstr(req, "{\"status\":\"success\",\"message\":\"Break configuration sent via ESP-NOW\"}");
    } else {
        httpd_resp_sendstr(req, "{\"status\":\"error\",\"message\":\"Failed to send break configuration\"}");
    }
    
    return ESP_OK;
}


// 
// 
//--------------- Del 5: Flere API Handlers og WebSocket-håndtering ---------------- 
// 
// 


// Handler for å sette konfigurasjon for passerings-deteksjon
esp_err_t set_passage_config_handler(httpd_req_t *req) {
    char buf[100];
    int ret, remaining = req->content_len;
    
    ESP_LOGI(TAG, "set_passage_config_handler called, content_len: %d", remaining);
    
    if (remaining > sizeof(buf)) {
        httpd_resp_send_err(req, HTTPD_500_INTERNAL_SERVER_ERROR, "Request too large");
        return ESP_FAIL;
    }
    
    if ((ret = httpd_req_recv(req, buf, MIN(remaining, sizeof(buf)))) <= 0) {
        if (ret == HTTPD_SOCK_ERR_TIMEOUT) {
            httpd_resp_send_408(req);
        }
        return ESP_FAIL;
    }
    
    buf[ret] = '\0';
    ESP_LOGI(TAG, "Mottok data: %s", buf);
    
    // Parse JSON data
    int debounce_ms = -1;
    int min_sensors = -1;
    int timeout_ms = -1;
    
    // Sjekk debounce_ms
    char *debounce_start = strstr(buf, "\"debounce_ms\":");
    if (debounce_start) {
        debounce_start += 14; // Hopp over "debounce_ms":
        debounce_ms = atoi(debounce_start);
    }
    
    // Sjekk min_sensors
    char *min_sensors_start = strstr(buf, "\"min_sensors\":");
    if (min_sensors_start) {
        min_sensors_start += 14; // Hopp over "min_sensors":
        min_sensors = atoi(min_sensors_start);
    }
    
    // Sjekk timeout_ms
    char *timeout_start = strstr(buf, "\"timeout_ms\":");
    if (timeout_start) {
        timeout_start += 13; // Hopp over "timeout_ms":
        timeout_ms = atoi(timeout_start);
    }
    

    // Oppdater konfigurasjon
    bool config_changed = false;

    if (debounce_ms >= 500 && debounce_ms <= 15000) { // 0.5 til 15 50 sekunder
        passage_debounce_ms = debounce_ms;
        ESP_LOGI(TAG, "Passering debounce-tid satt til %d ms", passage_debounce_ms);
        config_changed = true;
    }

    if (min_sensors > 0 && min_sensors <= MAX_SENSORS_PER_POLE) {
        min_sensors_for_passage = min_sensors;
        ESP_LOGI(TAG, "Minimum sensorer for passering satt til %d", min_sensors_for_passage);
        config_changed = true;
    }

    if (timeout_ms >= 100 && timeout_ms <= 1000) { // Mellom 0.1 og 1 sekunder
        sequence_timeout_ms = timeout_ms;
        ESP_LOGI(TAG, "Timeout for sekvens satt til %d ms", sequence_timeout_ms);
        config_changed = true;
    }

    // Lagre til NVS hvis noe ble endret
    if (config_changed) {
        save_passage_config_to_nvs();
    }

    
    // Send respons
    httpd_resp_set_type(req, "application/json");
    httpd_resp_set_hdr(req, "Access-Control-Allow-Origin", "*");
    
    char response[256];
    sprintf(response, "{\"status\":\"success\",\"config\":{\"debounce_ms\":%d,\"min_sensors\":%d,\"timeout_ms\":%d}}",
            passage_debounce_ms, min_sensors_for_passage, sequence_timeout_ms);
    
    httpd_resp_sendstr(req, response);
    
    return ESP_OK;
}

// Handler for å hente nåværende konfigurasjon for passerings-deteksjon
esp_err_t get_passage_config_handler(httpd_req_t *req) {
    ESP_LOGI(TAG, "get_passage_config_handler called");
    
    // Send gjeldende konfigurasjon
    char response[256];
    sprintf(response, "{\"status\":\"success\",\"config\":{\"debounce_ms\":%d,\"min_sensors\":%d,\"timeout_ms\":%d}}",
            passage_debounce_ms, min_sensors_for_passage, sequence_timeout_ms);
    
    httpd_resp_set_type(req, "application/json");
    httpd_resp_set_hdr(req, "Access-Control-Allow-Origin", "*");
    httpd_resp_sendstr(req, response);
    
    return ESP_OK;
}






// API handler for signalkvalitet
esp_err_t get_signal_quality_handler(httpd_req_t *req) {
    ESP_LOGI(TAG, "get_signal_quality_handler called");
    
    // CORS headers
    httpd_resp_set_hdr(req, "Access-Control-Allow-Origin", "*");
    
    if (req->method == HTTP_OPTIONS) {
        httpd_resp_send(req, NULL, 0);
        return ESP_OK;
    }
    
    xSemaphoreTake(signal_mutex, portMAX_DELAY);


    // Debug logging
    ESP_LOGD(TAG, "📊 get_signal_quality_handler: signal_tracking_count = %d", signal_tracking_count);
    for (int i = 0; i < signal_tracking_count; i++) {
        ESP_LOGD(TAG, "📊 Signal entry %d: MAC=%02x:%02x:%02x:%02x:%02x:%02x, RSSI=%d, packets=%u", 
                 i, signal_tracking[i].mac[0], signal_tracking[i].mac[1], signal_tracking[i].mac[2],
                 signal_tracking[i].mac[3], signal_tracking[i].mac[4], signal_tracking[i].mac[5],
                 signal_tracking[i].last_rssi, signal_tracking[i].packets_received);
    }

    
    // Bygg JSON-respons
    char *response = malloc(1536);
    if (!response) {
        xSemaphoreGive(signal_mutex);
        httpd_resp_send_500(req);
        return ESP_FAIL;
    }
    
    int pos = sprintf(response, "{\"status\":\"success\",\"signal_data\":[");
    
    for (int i = 0; i < signal_tracking_count; i++) {
        signal_quality_t *sq = &signal_tracking[i];
        
        // Beregn pakketap (forenklet beregning for nå)
        uint32_t packet_loss_percent = 0; // TODO: Implementer faktisk pakketap-beregning
        
        // Beregn overall kvalitet
        int quality = calculate_signal_quality(sq->avg_rssi, packet_loss_percent);
        
        pos += sprintf(response + pos,
            "%s{\"mac\":\"%02x:%02x:%02x:%02x:%02x:%02x\","
            "\"rssi\":%d,"
            "\"avg_rssi\":%d,"
            "\"quality\":%d,"
            "\"packets_received\":%" PRIu32 ","
            "\"packet_loss_percent\":%" PRIu32 ","
            "\"last_update\":%lld}",
            (i > 0) ? "," : "",
            sq->mac[0], sq->mac[1], sq->mac[2], sq->mac[3], sq->mac[4], sq->mac[5],
            sq->last_rssi,
            sq->avg_rssi,
            quality,
            sq->packets_received,
            packet_loss_percent,
            sq->last_update
        );
    }
    
    pos += sprintf(response + pos, "]}");
    
    xSemaphoreGive(signal_mutex);
    
    httpd_resp_set_type(req, "application/json");
    httpd_resp_sendstr(req, response);
    
    free(response);
    return ESP_OK;
}






// Handler for å beregne stoppeklokke-tid mellom to målestolper
esp_err_t calculate_stopwatch_handler(httpd_req_t *req) {
    char buf[200];
    int ret, remaining = req->content_len;
    
    ESP_LOGI(TAG, "calculate_stopwatch_handler called, content_len: %d", remaining);
    
    // Legg til CORS-headere
    httpd_resp_set_hdr(req, "Access-Control-Allow-Origin", "*");
    
    if (req->method == HTTP_OPTIONS) {
        httpd_resp_send(req, NULL, 0);
        return ESP_OK;
    }
    
    if (remaining > sizeof(buf)) {
        httpd_resp_send_err(req, HTTPD_500_INTERNAL_SERVER_ERROR, "Request too large");
        return ESP_FAIL;
    }
    
    if ((ret = httpd_req_recv(req, buf, MIN(remaining, sizeof(buf)))) <= 0) {
        if (ret == HTTPD_SOCK_ERR_TIMEOUT) {
            httpd_resp_send_408(req);
        }
        return ESP_FAIL;
    }
    
    buf[ret] = '\0';
    ESP_LOGI(TAG, "Mottok data: %s", buf);
    
    // Parse JSON data for MAC-adressene
    char mac1[18] = {0}, mac2[18] = {0};
    
    // Finn første MAC-adresse
    char *mac1_start = strstr(buf, "\"mac1\":\"");
    if (mac1_start) {
        mac1_start += 8; // Hopp over "mac1":"
        char *mac1_end = strchr(mac1_start, '\"');
        if (mac1_end && (mac1_end - mac1_start) < 18) {
            strncpy(mac1, mac1_start, mac1_end - mac1_start);
            mac1[mac1_end - mac1_start] = '\0';
        }
    }
    
    // Finn andre MAC-adresse
    char *mac2_start = strstr(buf, "\"mac2\":\"");
    if (mac2_start) {
        mac2_start += 8; // Hopp over "mac2":"
        char *mac2_end = strchr(mac2_start, '\"');
        if (mac2_end && (mac2_end - mac2_start) < 18) {
            strncpy(mac2, mac2_start, mac2_end - mac2_start);
            mac2[mac2_end - mac2_start] = '\0';
        }
    }
    
    ESP_LOGI(TAG, "Beregner stoppeklokke-tid mellom MAC1: %s og MAC2: %s", mac1, mac2);
    
    if (strlen(mac1) > 0 && strlen(mac2) > 0) {
        // Konverter MAC-adressene til bytes
        uint8_t mac1_bytes[ESP_NOW_ETH_ALEN], mac2_bytes[ESP_NOW_ETH_ALEN];
        
        sscanf(mac1, "%hhx:%hhx:%hhx:%hhx:%hhx:%hhx", 
               &mac1_bytes[0], &mac1_bytes[1], &mac1_bytes[2],
               &mac1_bytes[3], &mac1_bytes[4], &mac1_bytes[5]);
        
        sscanf(mac2, "%hhx:%hhx:%hhx:%hhx:%hhx:%hhx", 
               &mac2_bytes[0], &mac2_bytes[1], &mac2_bytes[2],
               &mac2_bytes[3], &mac2_bytes[4], &mac2_bytes[5]);
        
        // Beregn stoppeklokke-tid
        uint64_t elapsed_ms = calculate_stopwatch_time_ms(mac1_bytes, mac2_bytes);
        
        // Send respons
        char response[256];
        sprintf(response, "{\"status\":\"success\",\"elapsed_ms\":%llu,\"mac1\":\"%s\",\"mac2\":\"%s\"}", 
                elapsed_ms, mac1, mac2);
        
        httpd_resp_set_type(req, "application/json");
        httpd_resp_set_hdr(req, "Access-Control-Allow-Origin", "*");
        httpd_resp_sendstr(req, response);
    } else {
        ESP_LOGW(TAG, "Ugyldig forespørsel - mangler MAC-adresser");
        httpd_resp_set_type(req, "application/json");
        httpd_resp_set_hdr(req, "Access-Control-Allow-Origin", "*");
        httpd_resp_sendstr(req, "{\"status\":\"error\",\"message\":\"Mangler MAC-adresser\"}");
    }
    
    return ESP_OK;
}



// Funksjon for å initialisere System ID
void initialize_system_id(void) {
    nvs_handle_t nvs_handle;
    esp_err_t err;
    
    // Åpne NVS
    err = nvs_open("system", NVS_READWRITE, &nvs_handle);
    if (err != ESP_OK) {
        ESP_LOGE(TAG, "Feil ved åpning av NVS for system ID: %s", esp_err_to_name(err));
        return;
    }
    
    // Prøv å lese eksisterende System ID
    err = nvs_get_u32(nvs_handle, "system_id", &current_system_id);
    
    if (err == ESP_ERR_NVS_NOT_FOUND) {
        // Generer nytt System ID fra MAC-adresse
        uint8_t mac[6];
        esp_err_t mac_err = esp_read_mac(mac, ESP_MAC_WIFI_STA);
        
        if (mac_err == ESP_OK) {
            // Bruk siste 4 bytes av MAC for å lage System ID
            current_system_id = (mac[2] << 24) | (mac[3] << 16) | (mac[4] << 8) | mac[5];
            
            // Sikre at System ID aldri er 0x00000000 (reservert for broadcast)
            if (current_system_id == 0x00000000) {
                current_system_id = 0x00000001;
            }
            
            // Lagre System ID permanent
            err = nvs_set_u32(nvs_handle, "system_id", current_system_id);
            if (err == ESP_OK) {
                err = nvs_commit(nvs_handle);
                if (err == ESP_OK) {
                    ESP_LOGI(TAG, "🆔 Nytt System ID generert og lagret: %08X", current_system_id);
                } else {
                    ESP_LOGE(TAG, "Feil ved commit av System ID: %s", esp_err_to_name(err));
                }
            } else {
                ESP_LOGE(TAG, "Feil ved lagring av System ID: %s", esp_err_to_name(err));
            }
        } else {
            ESP_LOGE(TAG, "Kunne ikke lese MAC-adresse for System ID generering: %s", esp_err_to_name(mac_err));
            current_system_id = 0x12345678;  // Fallback
        }
    } else if (err == ESP_OK) {
        ESP_LOGI(TAG, "📱 System ID lastet fra NVS: %08X", current_system_id);
    } else {
        ESP_LOGE(TAG, "Feil ved lesing av System ID fra NVS: %s", esp_err_to_name(err));
        current_system_id = 0x12345678;  // Fallback
    }
    
    nvs_close(nvs_handle);
}




// Funksjon for å håndtere announce-meldinger fra målestolper
void handle_pole_announce(const pole_announce_t *announce, int8_t rssi) {
    // Ignorer meldinger som ikke er for discovery (system_id != 0)
    if (announce->system_id != 0x00000000) {
        return;
    }
    
    ESP_LOGI(TAG, "📢 Mottok announce fra målestolpe: %s (MAC: %02x:%02x:%02x:%02x:%02x:%02x, RSSI: %d)",
             announce->device_name,
             announce->mac[0], announce->mac[1], announce->mac[2],
             announce->mac[3], announce->mac[4], announce->mac[5],
             rssi);
    
    // Legg til eller oppdater i discovered poles liste
    add_or_update_discovered_pole(announce, rssi);
    
    // Send oppdatering til GUI
    send_discovery_update_to_gui();



    // Registrer målestolpen som ESP-NOW peer for assignment-sending
    esp_now_peer_info_t peer_info = {0};
    memcpy(peer_info.peer_addr, announce->mac, ESP_NOW_ETH_ALEN);
    peer_info.channel = 0;  // Samme kanal som WiFi
    peer_info.ifidx = WIFI_IF_AP;  // AP interface
    peer_info.encrypt = false;
    
    // Sjekk først om peer allerede eksisterer
    bool peer_exists = esp_now_is_peer_exist(announce->mac);
    if (peer_exists) {
        ESP_LOGD(TAG, "ESP-NOW peer allerede registrert, hopper over");
        xSemaphoreGive(discovery_mutex);
        send_discovery_update_to_gui();
        return;
    }


    esp_err_t peer_result = esp_now_add_peer(&peer_info);
    if (peer_result == ESP_OK) {
        ESP_LOGI(TAG, "✅ Registrert målestolpe som ESP-NOW peer: %02x:%02x:%02x:%02x:%02x:%02x",
                 announce->mac[0], announce->mac[1], announce->mac[2],
                 announce->mac[3], announce->mac[4], announce->mac[5]);
    } else if (peer_result == ESP_ERR_ESPNOW_EXIST) {
        ESP_LOGD(TAG, "ESP-NOW peer allerede registrert");
    } else {
        ESP_LOGE(TAG, "❌ Feil ved registrering av ESP-NOW peer: %s", esp_err_to_name(peer_result));
    }


}

// Funksjon for å legge til eller oppdatere oppdaget målestolpe
void add_or_update_discovered_pole(const pole_announce_t *announce, int8_t rssi) {
    xSemaphoreTake(discovery_mutex, portMAX_DELAY);


    // Valider at announce er for discovery (system_id skal være 0)
    if (announce->system_id != 0x00000000) {
        ESP_LOGW(TAG, "⚠️ Mottok announce med ugyldig system_id %08X (forventet 0x00000000)", 
                 announce->system_id);
        xSemaphoreGive(discovery_mutex);
        return;
    }
    
    // Sjekk om denne målestolpen allerede er oppdaget
    int existing_index = -1;
    for (int i = 0; i < discovered_pole_count; i++) {
        if (memcmp(discovered_poles[i].mac, announce->mac, 6) == 0) {
            existing_index = i;
            break;
        }
    }
    
    if (existing_index >= 0) {
        // Oppdater eksisterende oppføring
        discovered_poles[existing_index].last_seen = time(NULL);
        discovered_poles[existing_index].rssi = rssi;
        
        ESP_LOGI(TAG, "🔄 Oppdatert eksisterende målestolpe: %s", announce->device_name);
    } else {
        // Legg til ny målestolpe hvis vi har plass
        if (discovered_pole_count < MAX_DISCOVERED_POLES) {
            discovered_pole_t *new_pole = &discovered_poles[discovered_pole_count];
            
            memcpy(new_pole->mac, announce->mac, 6);
            strncpy(new_pole->device_name, announce->device_name, sizeof(new_pole->device_name) - 1);
            new_pole->device_name[sizeof(new_pole->device_name) - 1] = '\0';
            new_pole->first_seen = time(NULL);
            new_pole->last_seen = time(NULL);
            new_pole->rssi = rssi;
            new_pole->identifying = false;
            memcpy(new_pole->firmware_ver, announce->firmware_ver, 3);
            
            discovered_pole_count++;
            
            ESP_LOGI(TAG, "✅ Lagt til ny målestolpe: %s (totalt: %d)", 
                     announce->device_name, discovered_pole_count);
        } else {
            ESP_LOGW(TAG, "⚠️ Kan ikke legge til flere målestolper - maksimalt %d nådd", MAX_DISCOVERED_POLES);
        }
    }
    
    xSemaphoreGive(discovery_mutex);
}






// Funksjon for å sende discovery-oppdateringer til GUI
void send_discovery_update_to_gui(void) {
    if (!global_server) {
        return;  // Server ikke initialisert ennå
    }
    
    xSemaphoreTake(discovery_mutex, portMAX_DELAY);
    
    // Bygg JSON med oppdagede målestolper
    char *json_msg = malloc(2048);  // Stor nok buffer for alle målestolpene
    if (!json_msg) {
        xSemaphoreGive(discovery_mutex);
        return;
    }
    
    int pos = sprintf(json_msg, "{\"type\":\"discovery_update\",\"poles\":[");
    
    for (int i = 0; i < discovered_pole_count; i++) {
        discovered_pole_t *pole = &discovered_poles[i];
        
        // Estimer avstand basert på RSSI (grov tilnærming)
        int estimated_distance = 0;
        if (pole->rssi > -40) {
            estimated_distance = 5;
        } else if (pole->rssi > -60) {
            estimated_distance = 20;
        } else if (pole->rssi > -80) {
            estimated_distance = 100;
        } else {
            estimated_distance = 200;
        }
        
        pos += sprintf(json_msg + pos,
            "%s{\"mac\":\"%02x:%02x:%02x:%02x:%02x:%02x\","
            "\"device_name\":\"%s\","
            "\"first_seen\":%lld,"
            "\"last_seen\":%lld,"
            "\"rssi\":%d,"
            "\"estimated_distance\":%d,"
            "\"identifying\":%s,"
            "\"firmware_ver\":[%d,%d,%d]}",
            (i > 0) ? "," : "",
            pole->mac[0], pole->mac[1], pole->mac[2],
            pole->mac[3], pole->mac[4], pole->mac[5],
            pole->device_name,
            pole->first_seen,
            pole->last_seen,
            pole->rssi,
            estimated_distance,
            pole->identifying ? "true" : "false",
            pole->firmware_ver[0], pole->firmware_ver[1], pole->firmware_ver[2]
        );
    }
    
    pos += sprintf(json_msg + pos, "]}");
    
    xSemaphoreGive(discovery_mutex);
    
    // Send til alle WebSocket-klienter
    httpd_ws_frame_t ws_pkt = {
        .final = true,
        .fragmented = false,
        .type = HTTPD_WS_TYPE_TEXT,
        .payload = (uint8_t *)json_msg,
        .len = strlen(json_msg)
    };
    
    xSemaphoreTake(ws_mutex, portMAX_DELAY);
    for (int i = 0; i < MAX_WS_CLIENTS; ++i) {
        if (ws_clients[i] != 0) {
            httpd_ws_send_frame_async(global_server, ws_clients[i], &ws_pkt);
        }
    }
    xSemaphoreGive(ws_mutex);
    
    free(json_msg);
    
    ESP_LOGI(TAG, "📤 Sendt discovery-oppdatering til GUI (%d målestolper)", discovered_pole_count);
}



// API handler for å hente oppdagede målestolper
esp_err_t get_discovered_poles_handler(httpd_req_t *req) {
    ESP_LOGI(TAG, "get_discovered_poles_handler called");
    
    // CORS headers
    httpd_resp_set_hdr(req, "Access-Control-Allow-Origin", "*");
    
    if (req->method == HTTP_OPTIONS) {
        httpd_resp_send(req, NULL, 0);
        return ESP_OK;
    }
    
    xSemaphoreTake(discovery_mutex, portMAX_DELAY);
    
    // Bygg JSON-respons
    char *response = malloc(1536);
    if (!response) {
        xSemaphoreGive(discovery_mutex);
        httpd_resp_send_500(req);
        return ESP_FAIL;
    }
    
    int pos = sprintf(response, "{\"status\":\"success\",\"system_id\":\"%08" PRIX32 "\",\"discovery_active\":%s,\"poles\":[",
                     current_system_id, discovery_active ? "true" : "false");
    
    for (int i = 0; i < discovered_pole_count; i++) {
        discovered_pole_t *pole = &discovered_poles[i];
        
        // Beregn hvor lenge siden sist sett
        time_t now = time(NULL);
        long seconds_since_last_seen = now - pole->last_seen;
        
        // Estimer avstand basert på RSSI
        int estimated_distance = 0;
        if (pole->rssi > -40) {
            estimated_distance = 5;
        } else if (pole->rssi > -60) {
            estimated_distance = 20;
        } else if (pole->rssi > -80) {
            estimated_distance = 100;
        } else {
            estimated_distance = 200;
        }
        
        pos += sprintf(response + pos,
            "%s{\"mac\":\"%02x:%02x:%02x:%02x:%02x:%02x\","
            "\"device_name\":\"%s\","
            "\"first_seen\":%lld,"
            "\"last_seen\":%lld,"
            "\"seconds_since_last_seen\":%ld,"
            "\"rssi\":%d,"
            "\"estimated_distance\":%d,"
            "\"identifying\":%s,"
            "\"firmware_ver\":[%d,%d,%d]}",
            (i > 0) ? "," : "",
            pole->mac[0], pole->mac[1], pole->mac[2],
            pole->mac[3], pole->mac[4], pole->mac[5],
            pole->device_name,
            pole->first_seen,
            pole->last_seen,
            seconds_since_last_seen,
            pole->rssi,
            estimated_distance,
            pole->identifying ? "true" : "false",
            pole->firmware_ver[0], pole->firmware_ver[1], pole->firmware_ver[2]
        );
    }
    
    pos += sprintf(response + pos, "]}");
    
    xSemaphoreGive(discovery_mutex);
    
    httpd_resp_set_type(req, "application/json");
    httpd_resp_set_hdr(req, "Access-Control-Allow-Origin", "*");
    httpd_resp_sendstr(req, response);
    
    free(response);
    return ESP_OK;
}




// API handler for å identifisere en målestolpe (få den til å blinke)
esp_err_t identify_pole_handler(httpd_req_t *req) {
    char buf[200];
    int ret, remaining = req->content_len;
    
    ESP_LOGI(TAG, "identify_pole_handler called, content_len: %d", remaining);
    
    // CORS headers
    httpd_resp_set_hdr(req, "Access-Control-Allow-Origin", "*");
    
    if (req->method == HTTP_OPTIONS) {
        httpd_resp_send(req, NULL, 0);
        return ESP_OK;
    }
    
    if (remaining > sizeof(buf)) {
        httpd_resp_send_err(req, HTTPD_500_INTERNAL_SERVER_ERROR, "Request too large");
        return ESP_FAIL;
    }
    
    if ((ret = httpd_req_recv(req, buf, MIN(remaining, sizeof(buf)))) <= 0) {
        if (ret == HTTPD_SOCK_ERR_TIMEOUT) {
            httpd_resp_send_408(req);
        }
        return ESP_FAIL;
    }
    
    buf[ret] = '\0';
    ESP_LOGI(TAG, "Mottok identify data: %s", buf);
    
    // Parse MAC-adresse og varighet fra JSON
    uint8_t target_mac[6];
    char mac_str[18] = {0};
    uint8_t duration_sec = 10; // Standard 10 sekunder
    
    // Parse MAC-adresse
    char *mac_start = strstr(buf, "\"mac\":\"");
    if (mac_start) {
        mac_start += 7; // Hopp over "mac":"
        char *mac_end = strchr(mac_start, '\"');
        if (mac_end && (mac_end - mac_start) < 18) {
            strncpy(mac_str, mac_start, mac_end - mac_start);
            mac_str[mac_end - mac_start] = '\0';
            
            // Konverter MAC-streng til bytes
            if (sscanf(mac_str, "%hhx:%hhx:%hhx:%hhx:%hhx:%hhx", 
                      &target_mac[0], &target_mac[1], &target_mac[2],
                      &target_mac[3], &target_mac[4], &target_mac[5]) == 6) {
                
                // Parse varighet (valgfritt)
                char *duration_start = strstr(buf, "\"duration\":");
                if (duration_start) {
                    duration_start += 11; // Hopp over "duration":
                    int parsed_duration = atoi(duration_start);
                    if (parsed_duration >= 5 && parsed_duration <= 30) {
                        duration_sec = (uint8_t)parsed_duration;
                    }
                }
                
                ESP_LOGI(TAG, "Sender identify-forespørsel til målestolpe: %s (varighet: %d sek)", 
                         mac_str, duration_sec);
                
                // Opprett og send identify-melding
                identify_request_t identify_msg = {0};
                identify_msg.system_id = current_system_id;
                identify_msg.msg_type = MSG_IDENTIFY_REQUEST;
                memcpy(identify_msg.target_mac, target_mac, 6);
                identify_msg.duration_sec = duration_sec;
                
                esp_err_t result = esp_now_send(target_mac, (uint8_t*)&identify_msg, sizeof(identify_msg));
                
                if (result == ESP_OK) {
                    ESP_LOGI(TAG, "✅ Identify-forespørsel sendt vellykket til %s", mac_str);
                    httpd_resp_set_type(req, "application/json");
                    httpd_resp_set_hdr(req, "Access-Control-Allow-Origin", "*");
                    httpd_resp_sendstr(req, "{\"status\":\"success\",\"message\":\"Identify-kommando sendt\"}");
                } else {
                    ESP_LOGE(TAG, "❌ Feil ved sending av identify-forespørsel: %s", esp_err_to_name(result));
                    httpd_resp_set_type(req, "application/json");
                    httpd_resp_set_hdr(req, "Access-Control-Allow-Origin", "*");
                    httpd_resp_sendstr(req, "{\"status\":\"error\",\"message\":\"Kunne ikke sende identify-kommando\"}");
                }
            } else {
                ESP_LOGW(TAG, "Ugyldig MAC-format: %s", mac_str);
                httpd_resp_set_type(req, "application/json");
                httpd_resp_set_hdr(req, "Access-Control-Allow-Origin", "*");
                httpd_resp_sendstr(req, "{\"status\":\"error\",\"message\":\"Ugyldig MAC-format\"}");
            }
        } else {
            ESP_LOGW(TAG, "Kunne ikke parse MAC fra JSON");
            httpd_resp_set_type(req, "application/json");
            httpd_resp_set_hdr(req, "Access-Control-Allow-Origin", "*");
            httpd_resp_sendstr(req, "{\"status\":\"error\",\"message\":\"MAC ikke funnet i request\"}");
        }
    } else {
        ESP_LOGW(TAG, "MAC ikke funnet i JSON");
        httpd_resp_set_type(req, "application/json");
        httpd_resp_set_hdr(req, "Access-Control-Allow-Origin", "*");
        httpd_resp_sendstr(req, "{\"status\":\"error\",\"message\":\"MAC ikke funnet i request\"}");
    }
    
    return ESP_OK;
}




// API handler for å hente System ID
esp_err_t get_system_id_handler(httpd_req_t *req) {
    ESP_LOGI(TAG, "get_system_id_handler called");
    
    // CORS headers
    httpd_resp_set_hdr(req, "Access-Control-Allow-Origin", "*");
    
    if (req->method == HTTP_OPTIONS) {
        httpd_resp_send(req, NULL, 0);
        return ESP_OK;
    }
    
    // Hent systemnavn fra NVS hvis det finnes
    char system_name[32] = "Timergate System";  // Standard navn
    nvs_handle_t nvs_handle;
    esp_err_t err = nvs_open("system", NVS_READONLY, &nvs_handle);
    if (err == ESP_OK) {
        size_t required_size = sizeof(system_name);
        nvs_get_str(nvs_handle, "system_name", system_name, &required_size);
        nvs_close(nvs_handle);
    }
    
    // Bygg JSON-respons
    char response[256];
    sprintf(response, 
        "{\"status\":\"success\","
        "\"system_id\":\"%08" PRIX32 "\","
        "\"system_name\":\"%s\","
        "\"discovery_active\":%s,"
        "\"discovered_pole_count\":%d}",
        current_system_id,
        system_name,
        discovery_active ? "true" : "false",
        discovered_pole_count
    );
    
    httpd_resp_set_type(req, "application/json");
    httpd_resp_set_hdr(req, "Access-Control-Allow-Origin", "*");
    httpd_resp_sendstr(req, response);
    
    return ESP_OK;
}





// Funksjon for å sende system assignment til målestolpe
bool send_system_assign_to_pole(const uint8_t *mac) {
    if (!mac) {
        ESP_LOGE(TAG, "Ugyldig MAC-adresse for system assignment");
        return false;
    }
    
    // Hent systemnavn fra NVS
    char system_name[32] = "Timergate System";
    nvs_handle_t nvs_handle;
    esp_err_t err = nvs_open("system", NVS_READONLY, &nvs_handle);
    if (err == ESP_OK) {
        size_t required_size = sizeof(system_name);
        nvs_get_str(nvs_handle, "system_name", system_name, &required_size);
        nvs_close(nvs_handle);
    }
    
    // Opprett system assignment-melding
    system_assign_t assign_msg = {0};
    assign_msg.system_id = current_system_id;
    assign_msg.msg_type = MSG_SYSTEM_ASSIGN;
    memcpy(assign_msg.target_mac, mac, 6);
    strncpy(assign_msg.system_name, system_name, sizeof(assign_msg.system_name) - 1);
    assign_msg.system_name[sizeof(assign_msg.system_name) - 1] = '\0';
    
    ESP_LOGI(TAG, "📤 Sender system assignment til målestolpe %02x:%02x:%02x:%02x:%02x:%02x",
             mac[0], mac[1], mac[2], mac[3], mac[4], mac[5]);
    ESP_LOGI(TAG, "   System ID: %08X, Navn: %s", current_system_id, system_name);
    
    // Send via ESP-NOW
    esp_err_t result = esp_now_send(mac, (uint8_t*)&assign_msg, sizeof(assign_msg));
    
    if (result == ESP_OK) {
        ESP_LOGI(TAG, "✅ System assignment sendt vellykket");
        return true;
    } else {
        ESP_LOGE(TAG, "❌ Feil ved sending av system assignment: %s", esp_err_to_name(result));
        return false;
    }
}



// Funksjon for å laste paired poles fra NVS
void load_paired_poles_from_nvs(void) {
    nvs_handle_t nvs_handle;
    esp_err_t err = nvs_open("paired_poles", NVS_READONLY, &nvs_handle);
    
    if (err != ESP_OK) {
        ESP_LOGI(TAG, "Ingen lagrede paired poles funnet - starter med tom liste");
        paired_pole_count = 0;
        return;
    }
    
    // Les antall paired poles
    err = nvs_get_i32(nvs_handle, "count", &paired_pole_count);
    if (err != ESP_OK || paired_pole_count < 0 || paired_pole_count > MAX_PAIRED_POLES) {
        ESP_LOGW(TAG, "Ugyldig paired poles count, nullstiller");
        paired_pole_count = 0;
        nvs_close(nvs_handle);
        return;
    }
    
    // Les paired poles data
    size_t required_size = sizeof(paired_poles);
    err = nvs_get_blob(nvs_handle, "data", paired_poles, &required_size);
    if (err != ESP_OK) {
        ESP_LOGE(TAG, "Kunne ikke lese paired poles data: %s", esp_err_to_name(err));
        paired_pole_count = 0;
    } else {
        ESP_LOGI(TAG, "🔗 Lastet %d paired poles fra NVS", paired_pole_count);
    }
    
    nvs_close(nvs_handle);
}

// Funksjon for å lagre paired poles til NVS
void save_paired_poles_to_nvs(void) {
    nvs_handle_t nvs_handle;
    esp_err_t err = nvs_open("paired_poles", NVS_READWRITE, &nvs_handle);
    
    if (err != ESP_OK) {
        ESP_LOGE(TAG, "Kunne ikke åpne NVS for paired poles: %s", esp_err_to_name(err));
        return;
    }
    
    // Lagre antall paired poles
    err = nvs_set_i32(nvs_handle, "count", paired_pole_count);
    if (err != ESP_OK) {
        ESP_LOGE(TAG, "Kunne ikke lagre paired poles count: %s", esp_err_to_name(err));
        nvs_close(nvs_handle);
        return;
    }
    
    // Lagre paired poles data
    err = nvs_set_blob(nvs_handle, "data", paired_poles, sizeof(paired_poles));
    if (err != ESP_OK) {
        ESP_LOGE(TAG, "Kunne ikke lagre paired poles data: %s", esp_err_to_name(err));
        nvs_close(nvs_handle);
        return;
    }
    
    // Commit endringer
    err = nvs_commit(nvs_handle);
    if (err != ESP_OK) {
        ESP_LOGE(TAG, "Kunne ikke committe paired poles NVS: %s", esp_err_to_name(err));
    } else {
        ESP_LOGI(TAG, "💾 Paired poles lagret i NVS (%d stk)", paired_pole_count);
    }
    
    nvs_close(nvs_handle);
}




// Funksjon for å legge til en paired pole
void add_paired_pole(const uint8_t *mac, const char *name) {
    xSemaphoreTake(paired_poles_mutex, portMAX_DELAY);
    
    // Sjekk om målestolpen allerede er paired
    for (int i = 0; i < paired_pole_count; i++) {
        if (memcmp(paired_poles[i].mac, mac, 6) == 0) {
            ESP_LOGW(TAG, "Målestolpe allerede paired, oppdaterer navn");
            strncpy(paired_poles[i].name, name ? name : "Navnløs målestolpe", sizeof(paired_poles[i].name) - 1);
            paired_poles[i].name[sizeof(paired_poles[i].name) - 1] = '\0';
            paired_poles[i].last_seen = time(NULL);
            xSemaphoreGive(paired_poles_mutex);
            save_paired_poles_to_nvs();
            return;
        }
    }
    
    // Legg til ny paired pole hvis vi har plass
    if (paired_pole_count < MAX_PAIRED_POLES) {
        paired_pole_t *new_pole = &paired_poles[paired_pole_count];
        
        memcpy(new_pole->mac, mac, 6);
        strncpy(new_pole->name, name ? name : "Navnløs målestolpe", sizeof(new_pole->name) - 1);
        new_pole->name[sizeof(new_pole->name) - 1] = '\0';
        new_pole->enabled = true;
        new_pole->paired_time = time(NULL);
        new_pole->last_seen = time(NULL);
        new_pole->firmware_version = 0;
        new_pole->user_notes[0] = '\0';
        
        paired_pole_count++;
        
        ESP_LOGI(TAG, "✅ Lagt til paired pole: %s (totalt: %d)", new_pole->name, paired_pole_count);
        
        save_paired_poles_to_nvs();
    } else {
        ESP_LOGW(TAG, "⚠️ Kan ikke legge til flere paired poles - maksimalt %d nådd", MAX_PAIRED_POLES);
    }
    
    xSemaphoreGive(paired_poles_mutex);
}

// Funksjon for å fjerne en paired pole
void remove_paired_pole(const uint8_t *mac) {
    xSemaphoreTake(paired_poles_mutex, portMAX_DELAY);
    
    for (int i = 0; i < paired_pole_count; i++) {
        if (memcmp(paired_poles[i].mac, mac, 6) == 0) {
            ESP_LOGI(TAG, "🗑️ Fjerner paired pole: %s", paired_poles[i].name);
            
            // Flytt siste element til denne posisjonen
            if (i < paired_pole_count - 1) {
                paired_poles[i] = paired_poles[paired_pole_count - 1];
            }
            paired_pole_count--;
            
            save_paired_poles_to_nvs();
            break;
        }
    }
    
    xSemaphoreGive(paired_poles_mutex);
}


// Hjelpefunksjon for å sjekke om en målestolpe er paired basert på MAC-adresse
bool is_paired_pole_by_mac(const uint8_t *mac) {
    if (!mac) {
        return false;
    }
    
    xSemaphoreTake(paired_poles_mutex, portMAX_DELAY);
    
    for (int i = 0; i < paired_pole_count; i++) {
        if (memcmp(paired_poles[i].mac, mac, 6) == 0) {
            xSemaphoreGive(paired_poles_mutex);
            return true;
        }
    }
    
    xSemaphoreGive(paired_poles_mutex);
    return false;
}


// API handler for å hente paired poles
esp_err_t get_paired_poles_handler(httpd_req_t *req) {
    ESP_LOGI(TAG, "get_paired_poles_handler called");
    
    // CORS headers
    httpd_resp_set_hdr(req, "Access-Control-Allow-Origin", "*");
    
    if (req->method == HTTP_OPTIONS) {
        httpd_resp_send(req, NULL, 0);
        return ESP_OK;
    }
    
    xSemaphoreTake(paired_poles_mutex, portMAX_DELAY);
    
    // Bygg JSON-respons
    char *response = malloc(2048);
    if (!response) {
        xSemaphoreGive(paired_poles_mutex);
        httpd_resp_send_500(req);
        return ESP_FAIL;
    }
    
    int pos = sprintf(response, "{\"status\":\"success\",\"system_id\":\"%08" PRIX32 "\",\"poles\":[",
                     current_system_id);
    
    for (int i = 0; i < paired_pole_count; i++) {
        paired_pole_t *pole = &paired_poles[i];
        
        // Beregn hvor lenge siden sist sett
        time_t now = time(NULL);
        long seconds_since_last_seen = now - pole->last_seen;
        
        pos += sprintf(response + pos,
            "%s{\"mac\":\"%02x:%02x:%02x:%02x:%02x:%02x\","
            "\"name\":\"%s\","
            "\"enabled\":%s,"
            "\"paired_time\":%lld,"
            "\"last_seen\":%lld,"
            "\"seconds_since_last_seen\":%ld,"
             "\"firmware_version\":%" PRIu32 ","
            "\"user_notes\":\"%s\"}",
            (i > 0) ? "," : "",
            pole->mac[0], pole->mac[1], pole->mac[2],
            pole->mac[3], pole->mac[4], pole->mac[5],
            pole->name,
            pole->enabled ? "true" : "false",
            pole->paired_time,
            pole->last_seen,
            seconds_since_last_seen,
            pole->firmware_version,
            pole->user_notes
        );
    }
    
    pos += sprintf(response + pos, "]}");
    
    xSemaphoreGive(paired_poles_mutex);
    
    httpd_resp_set_type(req, "application/json");
    httpd_resp_set_hdr(req, "Access-Control-Allow-Origin", "*");
    httpd_resp_sendstr(req, response);
    
    free(response);
    return ESP_OK;
}


// API handler for å fjerne en paired pole (oppdatert med unpair-kommando)
// API handler for å fjerne en paired pole (oppdatert med unpair-kommando)
esp_err_t unpair_pole_handler(httpd_req_t *req) {
    char buf[200];
    int ret, remaining = req->content_len;
    
    ESP_LOGI(TAG, "unpair_pole_handler called, content_len: %d", remaining);
    
    // CORS headers
    httpd_resp_set_hdr(req, "Access-Control-Allow-Origin", "*");
    
    if (req->method == HTTP_OPTIONS) {
        httpd_resp_send(req, NULL, 0);
        return ESP_OK;
    }
    
    if (remaining > sizeof(buf)) {
        httpd_resp_send_err(req, HTTPD_500_INTERNAL_SERVER_ERROR, "Request too large");
        return ESP_FAIL;
    }
    
    if ((ret = httpd_req_recv(req, buf, MIN(remaining, sizeof(buf)))) <= 0) {
        if (ret == HTTPD_SOCK_ERR_TIMEOUT) {
            httpd_resp_send_408(req);
        }
        return ESP_FAIL;
    }
    
    buf[ret] = '\0';
    ESP_LOGI(TAG, "Mottok unpair data: %s", buf);
    
    // Parse MAC-adresse fra JSON
    uint8_t target_mac[6];
    char mac_str[18] = {0};
    
    // Parse MAC-adresse
    char *mac_start = strstr(buf, "\"mac\":\"");
    if (mac_start) {
        mac_start += 7; // Hopp over "mac":"
        char *mac_end = strchr(mac_start, '"');
        if (mac_end && (mac_end - mac_start) < 18) {
            strncpy(mac_str, mac_start, mac_end - mac_start);
            mac_str[mac_end - mac_start] = '\0';
            
            // Konverter MAC-streng til bytes
            if (sscanf(mac_str, "%hhx:%hhx:%hhx:%hhx:%hhx:%hhx", 
                      &target_mac[0], &target_mac[1], &target_mac[2],
                      &target_mac[3], &target_mac[4], &target_mac[5]) == 6) {
                
                ESP_LOGI(TAG, "Fjerner paired pole og sender unpair-kommando: %s", mac_str);
                
                // 1. Send unpair-kommando til målestolpe (best effort)
                bool unpair_sent = send_esp_now_command_to_pole(target_mac, CMD_UNPAIR, NULL, 0);
                
                if (unpair_sent) {
                    ESP_LOGI(TAG, "✅ Unpair-kommando sendt til målestolpe");
                } else {
                    ESP_LOGW(TAG, "⚠️ Unpair-kommando feilet - kun lokal fjerning");
                }
                
                // Utvidet logging for debugging
                ESP_LOGI(TAG, "🔓 Unpair fullført for målestolpe %s:", mac_str);
                ESP_LOGI(TAG, "   - Kommando sendt: %s", unpair_sent ? "JA" : "NEI");
                ESP_LOGI(TAG, "   - Lokalt fjernet: JA");
                ESP_LOGI(TAG, "   - Forventet resultat: Målestolpe starter discovery-modus");
                
                // 2. Fjern fra paired_poles uansett
                remove_paired_pole(target_mac);
                
                // 3. Responder til GUI
                httpd_resp_set_type(req, "application/json");
                httpd_resp_set_hdr(req, "Access-Control-Allow-Origin", "*");
                
                if (unpair_sent) {
                    httpd_resp_sendstr(req, "{\"status\":\"success\",\"message\":\"Målestolpe fjernet og frigjort\"}");
                } else {
                    httpd_resp_sendstr(req, "{\"status\":\"success\",\"message\":\"Målestolpe fjernet lokalt (enheten utilgjengelig)\"}");
                }
                
                return ESP_OK;
            }
        }
    }
    
    ESP_LOGE(TAG, "Ugyldig MAC-adresse i unpair forespørsel");
    httpd_resp_set_type(req, "application/json");
    httpd_resp_set_hdr(req, "Access-Control-Allow-Origin", "*");
    httpd_resp_sendstr(req, "{\"status\":\"error\",\"message\":\"Ugyldig MAC-adresse\"}");
    
    return ESP_FAIL;
}

// API handler for å gi nytt navn til en paired pole
esp_err_t rename_pole_handler(httpd_req_t *req) {
    char buf[200];
    int ret, remaining = req->content_len;
    
    ESP_LOGI(TAG, "rename_pole_handler called, content_len: %d", remaining);
    
    // CORS headers
    httpd_resp_set_hdr(req, "Access-Control-Allow-Origin", "*");
    
    if (req->method == HTTP_OPTIONS) {
        httpd_resp_send(req, NULL, 0);
        return ESP_OK;
    }
    
    if (remaining > sizeof(buf)) {
        httpd_resp_send_err(req, HTTPD_500_INTERNAL_SERVER_ERROR, "Request too large");
        return ESP_FAIL;
    }
    
    if ((ret = httpd_req_recv(req, buf, MIN(remaining, sizeof(buf)))) <= 0) {
        if (ret == HTTPD_SOCK_ERR_TIMEOUT) {
            httpd_resp_send_408(req);
        }
        return ESP_FAIL;
    }
    
    buf[ret] = '\0';
    ESP_LOGI(TAG, "Mottok rename data: %s", buf);
    
    // Parse MAC-adresse og nytt navn fra JSON
    uint8_t target_mac[6];
    char mac_str[18] = {0};
    char new_name[32] = {0};
    
    // Parse MAC
    char *mac_start = strstr(buf, "\"mac\":\"");
    if (mac_start) {
        mac_start += 7;
        char *mac_end = strchr(mac_start, '\"');
        if (mac_end && (mac_end - mac_start) < 18) {
            strncpy(mac_str, mac_start, mac_end - mac_start);
            mac_str[mac_end - mac_start] = '\0';
        }
    }
    
    // Parse new name
    char *name_start = strstr(buf, "\"name\":\"");
    if (name_start) {
        name_start += 8;
        char *name_end = strchr(name_start, '\"');
        if (name_end && (name_end - name_start) < 32) {
            strncpy(new_name, name_start, name_end - name_start);
            new_name[name_end - name_start] = '\0';
        }
    }
    
    if (strlen(mac_str) > 0 && strlen(new_name) > 0) {
        // Konverter MAC-streng til bytes
        if (sscanf(mac_str, "%hhx:%hhx:%hhx:%hhx:%hhx:%hhx", 
                  &target_mac[0], &target_mac[1], &target_mac[2],
                  &target_mac[3], &target_mac[4], &target_mac[5]) == 6) {
            
            ESP_LOGI(TAG, "Endrer navn på paired pole %s til: %s", mac_str, new_name);
            
            // Oppdater navnet
            xSemaphoreTake(paired_poles_mutex, portMAX_DELAY);
            bool found = false;
            for (int i = 0; i < paired_pole_count; i++) {
                if (memcmp(paired_poles[i].mac, target_mac, 6) == 0) {
                    strncpy(paired_poles[i].name, new_name, sizeof(paired_poles[i].name) - 1);
                    paired_poles[i].name[sizeof(paired_poles[i].name) - 1] = '\0';
                    found = true;
                    break;
                }
            }
            xSemaphoreGive(paired_poles_mutex);
            
            if (found) {
                save_paired_poles_to_nvs();
                httpd_resp_set_type(req, "application/json");
                httpd_resp_set_hdr(req, "Access-Control-Allow-Origin", "*");
                httpd_resp_sendstr(req, "{\"status\":\"success\",\"message\":\"Målestolpe omdøpt\"}");
            } else {
                httpd_resp_set_type(req, "application/json");
                httpd_resp_set_hdr(req, "Access-Control-Allow-Origin", "*");
                httpd_resp_sendstr(req, "{\"status\":\"error\",\"message\":\"Målestolpe ikke funnet\"}");
            }
        } else {
            httpd_resp_set_type(req, "application/json");
            httpd_resp_set_hdr(req, "Access-Control-Allow-Origin", "*");
            httpd_resp_sendstr(req, "{\"status\":\"error\",\"message\":\"Ugyldig MAC-format\"}");
        }
    } else {
        httpd_resp_set_type(req, "application/json");
        httpd_resp_set_hdr(req, "Access-Control-Allow-Origin", "*");
        httpd_resp_sendstr(req, "{\"status\":\"error\",\"message\":\"Mangler MAC eller navn\"}");
    }
    
    return ESP_OK;
}






// API handler for å tilknytte en målestolpe til systemet
esp_err_t assign_pole_handler(httpd_req_t *req) {
    char buf[200];
    int ret, remaining = req->content_len;
    
    ESP_LOGI(TAG, "assign_pole_handler called, content_len: %d", remaining);
    
    // CORS headers
    httpd_resp_set_hdr(req, "Access-Control-Allow-Origin", "*");
    
    if (req->method == HTTP_OPTIONS) {
        httpd_resp_send(req, NULL, 0);
        return ESP_OK;
    }
    
    if (remaining > sizeof(buf)) {
        httpd_resp_send_err(req, HTTPD_500_INTERNAL_SERVER_ERROR, "Request too large");
        return ESP_FAIL;
    }
    
    if ((ret = httpd_req_recv(req, buf, MIN(remaining, sizeof(buf)))) <= 0) {
        if (ret == HTTPD_SOCK_ERR_TIMEOUT) {
            httpd_resp_send_408(req);
        }
        return ESP_FAIL;
    }
    
    buf[ret] = '\0';
    ESP_LOGI(TAG, "Mottok assign data: %s", buf);
    
    // Parse MAC-adresse fra JSON
    uint8_t target_mac[6];
    char mac_str[18] = {0};
    
    char *mac_start = strstr(buf, "\"mac\":\"");
    if (mac_start) {
        mac_start += 7; // Hopp over "mac":"
        char *mac_end = strchr(mac_start, '\"');
        if (mac_end && (mac_end - mac_start) < 18) {
            strncpy(mac_str, mac_start, mac_end - mac_start);
            mac_str[mac_end - mac_start] = '\0';
            
            // Konverter MAC-streng til bytes
            if (sscanf(mac_str, "%hhx:%hhx:%hhx:%hhx:%hhx:%hhx", 
                      &target_mac[0], &target_mac[1], &target_mac[2],
                      &target_mac[3], &target_mac[4], &target_mac[5]) == 6) {
                
                ESP_LOGI(TAG, "Tilknytter målestolpe: %s", mac_str);
                
                // Send system assignment til målestolpen
                if (send_system_assign_to_pole(target_mac)) {
                    // Fjern fra discovered poles liste
                    xSemaphoreTake(discovery_mutex, portMAX_DELAY);
                    
                    for (int i = 0; i < discovered_pole_count; i++) {
                        if (memcmp(discovered_poles[i].mac, target_mac, 6) == 0) {
                            // Flytt siste element til denne posisjonen
                            if (i < discovered_pole_count - 1) {
                                discovered_poles[i] = discovered_poles[discovered_pole_count - 1];
                            }
                            discovered_pole_count--;
                            ESP_LOGI(TAG, "Fjernet målestolpe fra discovered liste");
                            break;
                        }
                    }
                    
                    xSemaphoreGive(discovery_mutex);
                    
                    // Send oppdatering til GUI
                    send_discovery_update_to_gui();


                    // Legg til i paired poles liste
                    char pole_name[32];
                    sprintf(pole_name, "Målestolpe %02X%02X", target_mac[4], target_mac[5]);
                    add_paired_pole(target_mac, pole_name);
                    
                    ESP_LOGI(TAG, "✅ Målestolpe lagt til i paired poles: %s", pole_name);

                    
                    httpd_resp_set_type(req, "application/json");
                    httpd_resp_set_hdr(req, "Access-Control-Allow-Origin", "*");
                    httpd_resp_sendstr(req, "{\"status\":\"success\",\"message\":\"Målestolpe tilknyttet\"}");
                } else {
                    httpd_resp_set_type(req, "application/json");
                    httpd_resp_set_hdr(req, "Access-Control-Allow-Origin", "*");
                    httpd_resp_sendstr(req, "{\"status\":\"error\",\"message\":\"Kunne ikke sende tilknytning til målestolpe\"}");
                }
            } else {
                ESP_LOGW(TAG, "Ugyldig MAC-format: %s", mac_str);
                httpd_resp_set_type(req, "application/json");
                httpd_resp_set_hdr(req, "Access-Control-Allow-Origin", "*");
                httpd_resp_sendstr(req, "{\"status\":\"error\",\"message\":\"Ugyldig MAC-format\"}");
            }
        } else {
            ESP_LOGW(TAG, "Kunne ikke parse MAC fra JSON");
            httpd_resp_set_type(req, "application/json");
            httpd_resp_set_hdr(req, "Access-Control-Allow-Origin", "*");
            httpd_resp_sendstr(req, "{\"status\":\"error\",\"message\":\"MAC ikke funnet i request\"}");
        }
    } else {
        ESP_LOGW(TAG, "MAC ikke funnet i JSON");
        httpd_resp_set_type(req, "application/json");
        httpd_resp_set_hdr(req, "Access-Control-Allow-Origin", "*");
        httpd_resp_sendstr(req, "{\"status\":\"error\",\"message\":\"MAC ikke funnet i request\"}");
    }
    
    return ESP_OK;
}






// ================== POLE_ENABLED_HANDLER - REN ESP-NOW VERSJON ==================
esp_err_t pole_enabled_handler(httpd_req_t *req) {
    char buf[100];
    int ret, remaining = req->content_len;
    
    ESP_LOGI(TAG, "pole_enabled_handler called, content_len: %d", remaining);
    
    // CORS headers
    httpd_resp_set_hdr(req, "Access-Control-Allow-Origin", "*");
    
    if (req->method == HTTP_OPTIONS) {
        httpd_resp_send(req, NULL, 0);
        return ESP_OK;
    }
    
    if (remaining > sizeof(buf)) {
        httpd_resp_send_err(req, HTTPD_500_INTERNAL_SERVER_ERROR, "Request too large");
        return ESP_FAIL;
    }
    
    if ((ret = httpd_req_recv(req, buf, MIN(remaining, sizeof(buf)))) <= 0) {
        if (ret == HTTPD_SOCK_ERR_TIMEOUT) {
            httpd_resp_send_408(req);
        }
        return ESP_FAIL;
    }
    
    buf[ret] = '\0';
    ESP_LOGI(TAG, "Mottok data: %s", buf);
    
    // Parse JSON data
    char mac[18] = {0};
    int sensor = -1;
    bool enabled = false;
    
    // Parse MAC-adresse
    char *mac_start = strstr(buf, "\"mac\":\"");
    if (mac_start) {
        mac_start += 7; // Hopp over "mac":"
        char *mac_end = strchr(mac_start, '"');
        if (mac_end && (mac_end - mac_start) < 18) {
            strncpy(mac, mac_start, mac_end - mac_start);
            mac[mac_end - mac_start] = '\0';
        }
    }
    
    // Parse sensor nummer
    char *sensor_start = strstr(buf, "\"sensor\":");
    if (sensor_start) {
        sensor_start += 9; // Hopp over "sensor":
        sensor = atoi(sensor_start);
    }
    
    // Parse enabled status
    char *enabled_start = strstr(buf, "\"enabled\":");
    if (enabled_start) {
        enabled_start += 10; // Hopp over "enabled":
        // Sjekk for true/false eller 1/0
        if (strncmp(enabled_start, "true", 4) == 0) {
            enabled = true;
        } else if (strncmp(enabled_start, "false", 5) == 0) {
            enabled = false;
        } else {
            enabled = (atoi(enabled_start) != 0);
        }
    }
    
    ESP_LOGI(TAG, "Parsed values - MAC: %s, Sensor: %d, Enabled: %s", mac, sensor, enabled ? "true" : "false");
    
    bool success = false;
    
    if (strlen(mac) > 0 && sensor >= 0 && sensor < 7) {
        // Send enabled-konfigurasjon via ESP-NOW
        ESP_LOGI(TAG, "🔧 Sender enabled-konfigurasjon via ESP-NOW (MAC: %s, Sensor: %d, Enabled: %s)", 
                 mac, sensor, enabled ? "true" : "false");
        
        // Konverter MAC-streng til bytes
        uint8_t target_mac[6];
        
        if (sscanf(mac, "%hhx:%hhx:%hhx:%hhx:%hhx:%hhx", 
                  &target_mac[0], &target_mac[1], &target_mac[2],
                  &target_mac[3], &target_mac[4], &target_mac[5]) == 6) {
            
            // Opprett kommando-data for enabled-konfigurasjon (tilpasset målestolpens forventede format)
            uint8_t enabled_data[2];
            enabled_data[0] = (uint8_t)sensor;         // Sensor nummer
            enabled_data[1] = enabled ? 1 : 0;         // Enabled status (1=enabled, 0=disabled)
            
            success = send_esp_now_command_to_pole(
                target_mac, 
                CMD_SET_ENABLED, 
                enabled_data, 
                sizeof(enabled_data)
            );
            
            if (success) {
                ESP_LOGI(TAG, "✅ ESP-NOW enabled-konfigurasjon sendt til %s (Sensor %d = %s)", 
                         mac, sensor, enabled ? "aktivert" : "deaktivert");
            } else {
                ESP_LOGE(TAG, "❌ ESP-NOW enabled-konfigurasjon feilet for %s", mac);
            }
        } else {
            ESP_LOGW(TAG, "Ugyldig MAC-format: %s", mac);
        }
    } else {
        ESP_LOGW(TAG, "Ugyldig forespørsel - MAC: %s, Sensor: %d", mac, sensor);
    }
    
    // TCP-kode er helt fjernet - kun ESP-NOW i bruk
    
    httpd_resp_set_type(req, "application/json");
    httpd_resp_set_hdr(req, "Access-Control-Allow-Origin", "*");
    
    if (success) {
        httpd_resp_sendstr(req, "{\"status\":\"success\",\"message\":\"Sensor configuration sent via ESP-NOW\"}");
    } else {
        httpd_resp_sendstr(req, "{\"status\":\"error\",\"message\":\"Failed to send sensor configuration\"}");
    }
    
    return ESP_OK;
}


// Funksjon for å håndtere OPTIONS forespørsler (CORS preflight)
esp_err_t options_handler(httpd_req_t *req) {
   httpd_resp_set_hdr(req, "Access-Control-Allow-Origin", "*");
   httpd_resp_set_hdr(req, "Access-Control-Allow-Methods", "GET, POST, OPTIONS");
   httpd_resp_set_hdr(req, "Access-Control-Allow-Headers", "Content-Type, Accept, X-Requested-With");
   httpd_resp_send(req, NULL, 0);
   return ESP_OK;
}

// WebSocket-relaterte funksjoner
esp_err_t ws_handler(httpd_req_t *req) {
   if (req->method == HTTP_GET) {
       ESP_LOGI(TAG, "Handshake done, the new connection was opened");
       int fd = httpd_req_to_sockfd(req);

       xSemaphoreTake(ws_mutex, portMAX_DELAY);
       for (int i = 0; i < MAX_WS_CLIENTS; ++i) {
           if (ws_clients[i] == 0) {
               ws_clients[i] = fd;
               break;
           }
       }
       xSemaphoreGive(ws_mutex);
       return ESP_OK;
   }

   httpd_ws_frame_t frame = {
       .final = true,
       .fragmented = false,
       .type = HTTPD_WS_TYPE_TEXT
   };

   esp_err_t ret = httpd_ws_recv_frame(req, &frame, 0);
   if (ret != ESP_OK) {
       ESP_LOGE(TAG, "Failed to get frame length: %s", esp_err_to_name(ret));
       return ret;
   }

   frame.payload = malloc(frame.len + 1);
   if (!frame.payload) {
       return ESP_ERR_NO_MEM;
   }

   ret = httpd_ws_recv_frame(req, &frame, frame.len);
   if (ret != ESP_OK) {
       free(frame.payload);
       return ret;
   }

   ((char *)frame.payload)[frame.len] = 0;
   ESP_LOGI(TAG, "Received message: %s", (char *)frame.payload);
   free(frame.payload);
   return ESP_OK;
}



// 
// 
//--------------- Del 6: Filsystem og testing ---------------- 
// 
//
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
