devent-no/timergate_2/(commit log)

2024-08-15 Added PCB and 3D models
    [Alu-Base.FCStd, Alu-Pole.FCStd, Alu-Reflector.FCStd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]
2024-08-15 Add option to sync time between poles. Right now sync is done via socket and hardcoded Posix timestamp, but should use ESPnow to 'commit' at the same time. Should also add option to use a timestamp e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
2024-08-15 Added the ap firmware
    [partitions_example.csv]
2024-08-20 Central unit is now set up as an access point instead of connecting to local AP
    [2023-09-24T160709.csv, Alu-Reflector.FCStd, BoM.ods]
2025-01-06 New PCB revision almost ready
    [Alu-Calibration.FCStd, Alu-Pole.FCStd, IR-sensor-A2.step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]
2025-02-20 Rev A2 received, board bring-up on A2
    [Alu-Pole.FCStd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]
2025-02-21 Added option to disable a sensor, since it can interfere with the testing.
    [Alu-Pole.FCStd]
2025-04-16 several minor changes in config and timergate_server.c, flash ok
    [partitions_www.csv]
2025-04-17 some changes to fix webSocet connection
    [timergate_server.c]
2025-04-17 some more changes to fix gui connection
    [timergate_server.c]
2025-04-18 no build-flash issuees, button actions without fault-indication
    [timergate_server.c]
2025-04-18 before adjustment against original timergate_server.c and timergate_rest.c
2025-04-20 added correct mac-adr. handeling of 2 poles
    [timergate_server.c]
2025-04-23 added filteredbreak-logic
2025-04-28 more filtering before sending passage to gui
2025-05-08 Added timer-gui content
2025-05-12 timer-gui adjustments
2025-05-13 LED optimalization
2025-05-13 higpoint search fixing finished
    [timergate_pole.c]
2025-05-14 fixing missing wifi on startup
    [timergate_pole.c]
2025-05-14 more fixing missing wifi on startup
    [timergate_pole.c]
2025-05-16 Added support for IP/timergate.local gui config
2025-05-17 solving time jump issue
    [timergate_server.c]
2025-05-18 adding device reset etc
    [timergate_pole.c, timergate_server.c]
2025-05-19 change of defaults and calibration optimalization
2025-05-20 change of defaults and calibration optimalization2
2025-05-20 pole, more calibration fixes
    [timergate_pole.c]
2025-05-23 pole, added soft, hard and factory reset again
    [timergate_pole.c]
2025-05-23 gui, filtering not connected poles
2025-05-25 Timer log layout
2025-05-27 server cleanup
    [partitions_example.csv]
2025-05-31 updated passage detection, using pole times only, more error fixing
    [timergate_server.c]
2025-06-03 ESP_NOW migration phase 2 - part 1 done buld fix
    [timergate_server.c]
2025-06-05 ESP_NOW migration phase 6 - more bugfix
    [timergate_server.c]
2025-06-06 ESP_NOW migration phase 6 - more bugfix rssi
    [timergate_server.c]
2025-06-07 removed tcp from timergate-pole-a2
2025-06-08 pole led fix, removal of tcp-state
    [timergate_pole.c]
2025-06-09 pole fix for loss of AP, more...
    [timergate_pole.c]
2025-06-09 rolback to before fixing ap loss, got lost...
    [timergate_pole.c]
2025-06-11 pole, after refactoring, calibration need fix
    [timergate_pole.c]
2025-06-11 rolback, pole simlifiation destroyed calibration process
2025-06-11 🎉 TIMERGATE REFAKTORERING FULLFØRT - TOTAL SUKSESS
    Alle 4 faser gjennomført med perfekte resultater:
    FASE 0: ✅ Kalibrering løsrevet fra TCP-avhengighet
    FASE 1: ✅ WiFi reconnect system forenklet
    FASE 2: ✅ Status system redusert 8→4 statuser
    FASE 3: ✅ TCP system forenklet til minimal setup
    FASE 4: ✅ Ubrukt kode fjernet og ryddet
2025-08-19 Flere gui forbedringer, stolpestatus, klokkeformat og stopp/reset knapp
    [timergate_server.c]
2025-08-22 power montioring fase 1 - målestolpe er implementert
